iorodeo/noah_motion_system/README.txt

NOAH Motion System

Design files, software and firmware for the NOAH water tunnel motion control system.
