iorodeo/noah_motion_system/hardware/electronics/motion_controller/gerber_v0p1_r1/images/motion_controller_pcb.png

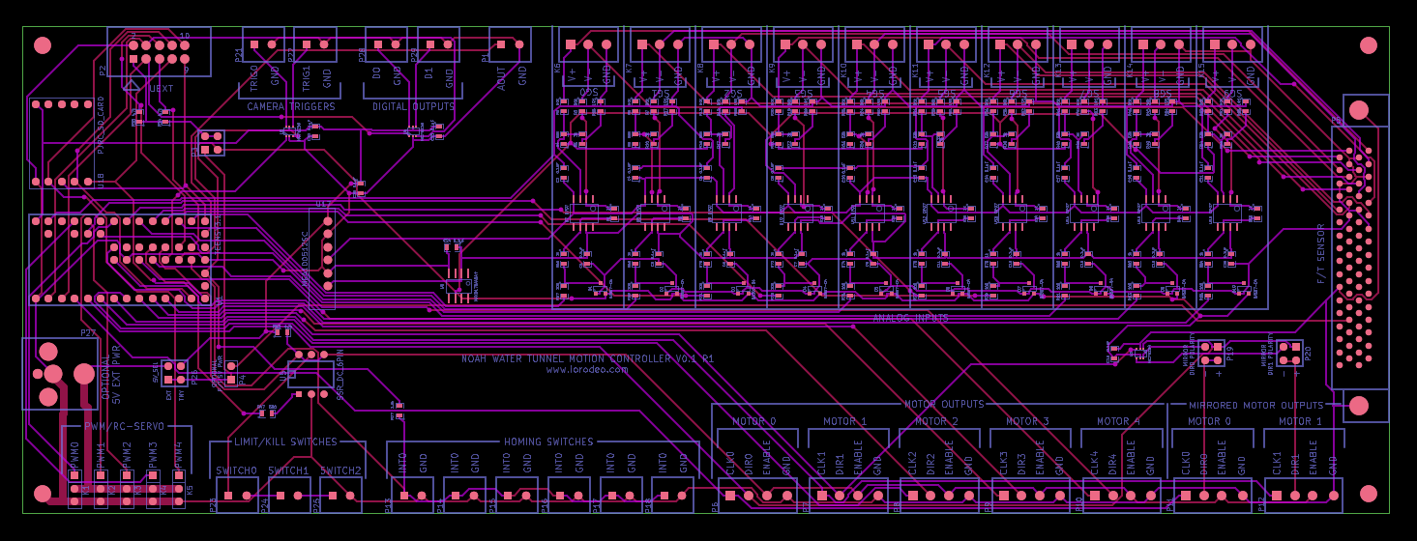
hardware/electronics/motion_controller/gerber_v0p1_r1/images/motion_controller_pcb.png
