iorodeo/noah_motion_system/hardware/mechanics/gantry_mounting_frame/mounting_frame.jpg

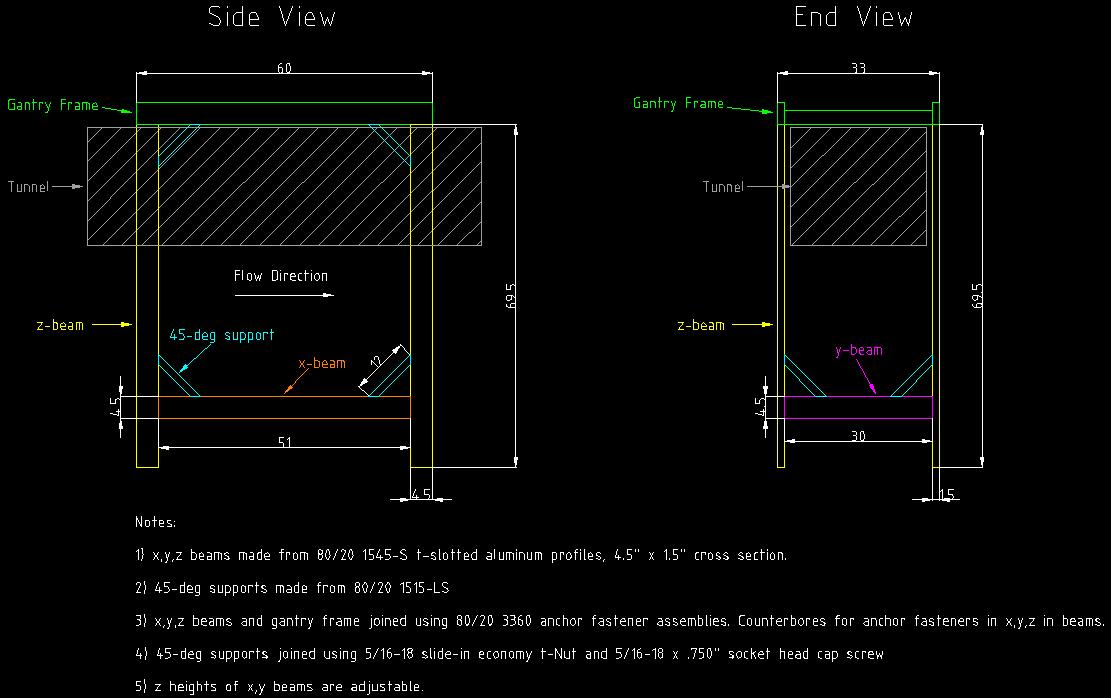
hardware/mechanics/gantry_mounting_frame/mounting_frame.jpg
