iorodeo/noah_motion_system/hardware/electronics/motion_controller/BOM.xls

 | Item # | Qty | Reference | Description | Package | PN | Vendor | Unit Cost | Cost
 | 1 | 25 | C1-C25 | 0.1 uF Ceramic Capacitor | SM0805 | 478-1395-1-ND | Digikey | 0.1 | 2.5
 | 2 | 10 | D1-D10 | Diode Array, 1-pair series conn , Schottky | SOT23 | BAS70-04-E3-08 | Digikey | 0.4 | 4
 | 3 | 15 | K1-K15 | 3-Pos. Term. Block, 3.5mm, Vert. | NA | ED2636-ND | Digikey | 0.64 | 9.6
 | 4 | 14 | P1, P13-P18, P21-P25, P28, P29 | 2-Pos. Term. Block, 3.5mm, Vert. | NA | ED2635-ND | Digikey | 0.43 | 6.02
 | 5 | 1 | P2 | 5x2 shrouded header, 0.1” | NA | S9169-ND | Digikey | 0.64 | 0.64
 | 6 | 4 | P3, P19, P20, P26 | Conn. Header 4-Pos, 2 row, 0.1” | NA | 609-3201-ND | Digkey | 0.28 | 1.12
 | 7 | 3 | P4, U1 | Conn. Header, breakaway 0.1” | NA | SAM1031-50-ND | Digikey | 3.3 | 9.9
 | 8 | 1 | P5 | 68-pin DSUB for NI cable, TE Connectivity | NA | A33476-ND | Digikey | 24.82 | 24.82
 | 9 | 7 | P6-P12 | 4-Pos. Term. Block, 3.5mm, Vert. | NA | ED2637-ND | Digikey | 0.77 | 5.39
 | 10 | 1 | P27 | 2.1mm DC Jack,high current | NA | CP-063AH-ND | Digikey | 1.78 | 1.78
 | 11 | 20 | R1, R5, R6, R10, R11, R17, R18, R22, R23, R28, R29, R33, R34, R38, R39. R43, R44, R49. R50. R55 | 3k resistor, tolerance 0.1% | SM0805 | P3.0KDACT-ND | Digikey | 0.53 | 10.6
 | 12 | 30 | R2, R3, R4, R7, R8, R9, R12, R13, R16, R19, R20, R21, R24, R25, R26, R30, R31, R32, R35, R36, R37, R40, R41, R42, R45, R46, R48, R51, R52, R54 | 50k resistor, tolerance 0.1% | SM0805 | PNM0805-50KBCT-ND | Digikey | 1.155 | 34.65
 | 13 | 3 | R14, R15, R53 | 4.7k resistor, tolerance 1% | SM0805 | 311-4.70KCRCT-ND | Digikey | 0.1 | 0.3
 | 14 | 1 | R27 | 3k resistor, tolerance 1% | SM0805 | 311-3.00KCRCT-ND | Digikey | 0.1 | 0.1
 | 15 | 10 | R56-R65 | 191 Ohm resistor, tolerance 0.1% | SM0805 | P191DACT-ND | Digikey | 0.63 | 6.3
 | 16 | 10 | R66, R68, R70, R72, R74, R76, R78, R80, R82, R84 | 1k resistor, tolerance 1% | SM0805 | 311-1.00KCRCT-ND | Digikey | 0.1 | 1
 | 17 | 10 | R67, R69, R71, R73, R75, R77, R79, R81, R83, R85 | 100 Ohm resistor, tolerance 1% | SM0805 | 311-100CRCT-ND | Digikey | 0.1 | 1
 | 18 | 1 | R47 | 499 Ohm resistor, tolerance 1% | SM0805 | 311-499CRCT-ND | Digikey | 0.1 | 0.1
 | 19 | 1 | U2 | NC7WZ04 Tiny logic Dual Inverter | SC-70-6 | NC7WZ04P6XCT-ND | Digikey | 0.41 | 0.41
 | 20 | 2 | U3, U4 | NC7WZ16 Tiny Logic Dual Buffer | SC-70-6 | NC7WZ16P6XCT-ND | Digikey | 0.39 | 0.78
 | 21 | 1 | U5 | LCA710 Solid State Relay | 6-DIP (0.3") | CLA181-ND | Digikey | 4.76 | 4.76
 | 22 | 1 | U5 | DIP Socket 6-Pos (3x2) | 6-DIP (0.3”) | AE1485-ND | Digikey | 0.24 | 0.24
 | 23 | 1 | U6 | Precision Voltage Reference (10V) | 8-SOIC | MAX6176AASA+-ND | Digikey | 4.57 | 4.57
 | 24 | 10 | U7-U16 | OP07x Precision Operational Amplifiers | 8-SOIC | 296-14626-1-ND | Digikey | 1.12 | 11.2
 | 25 | 1 | U17 | DC/DC converter +/-12V | 6-SIP Module (5 Leads) | 811-2678-5-ND | Digikey | 5.45 | 5.45
 | 26 | 1 | U18 | Micro SD Card Adaptor | NA | SD_ADAPTOR | PJRC | 8 | 8
 | 27 | 1 | U1 | Teensy 3.2 | NA | DEV-13736 | Sparkfun | 19.95 | 19.95
 | 28 | 1 | U1 | Surface mount header for Teensy 3.2 | NA | WM17453-ND | Digikey | 1.04 | 1.04
 | 29 | 2 | U1 | Female header for Teensy socket | NA | 929974E-01-36-ND | Digikey | 2.74 | 5.48
Totals | 29 | 188 |  |  |  |  |  |  | 181.7
 | Notes:
 | * P30-P33 are mounting holes – there is no component for these items.
 | * Alternate choice for item #12, 49.9k resistor, P49.9KDACT-ND, cost 0.63
