iorodeo/noah_motion_system/hardware/mechanics/gantry_mounting_frame/BOM.xlsx

Mounting Frame
Description | Quantity | Vendor | PN | price | subtotal
T-Slotted Aluminum Profile 1545-S, 69.5in Length, anchor counterbore E, H left end (see note1) | 4 | 80/20 | 1545-S | 105.5 | 422
T-Slotted Aluminum Profile 1545-S, 51.0in Length, anchor counterbore E, H left end right (see note1) | 2 | 80/20 | 1545-S | 84.35 | 168.7
T-Slotted Aluminum Profile 1545-S, 30.0in Length, anchor counterbore E, H left and right (see note1) | 2 | 80/20 | 1535-S | 62.75 | 125.5
15 Series 4.5" Economy Floor Mount Base Plate | 8 | 80/20 | 2405 | 15 | 120
15 Series 5/16-18 Standard Anchor Fastener Assembly | 30 | 80/20 | 3360 | 3.15 | 94.5
1515-LS 45 Degree Support, 12" Long | 12 | 80/20 | 2542 | 16.15 | 193.8
Bolt Assembly: 5/16-18 x .687" Black FBHSCS with Slide-In Economy T-Nut - Offset Thread - Black Zinc | 72 | 80/20 | 3320 | 0.6 | 43.2
 |  |  |  | Total | 1167.7
Note 1: See page 567 of 80/20 catalog for anchor fastener designations.
