iorodeo/noah_motion_system/hardware/mechanics/gantry_parts/BOM.xlsx

Motion Control Mechanics & Drive Electronics
Description | Quantity | Vendor | PN | price | subtotal
CRP2448 xyz CNC gantry kit w/ 3060 gantry extrusion, Nema 34 compatible | 1 | CNC router parts | CRP2448 | 2320 | 2320
4-axis Nema 34 Electronics kit, 2x12' & 2x20' cable, drive type G203V | 1 | CNC router parts | NA | 1549 | 1549
PMDX-133 3-axis daisey chainable mother board | 2 | CNC router parts | NA | 49 | 98
26-pin female-to-female ribbon cable 18" | 4 | PMDX | PMDX-HDR26Ribbon-18 | 8 | 32
7A Bulkhead Enclosure Connector | 3 | CNC router parts | NA | 11.95 | 35.85
High current CNC motor cable | 2 | CNC router parts | NA | 27.95 | 55.9
CRP2448 cable track kit | 1 | CNC router parts | NA | 199 | 199
48V 21A Power Supply | 1 | CNC router parts | NA | 239 | 239
3700 CNC rotary axis w/ motor mount | 1 | Sherline Direct | 3700-CNC | 336 | 336
3701 rotary axis right angle attachment plate | 1 | Sherline Direct | 3701-RIGHTANGLE | 78.75 | 78.75
Rotary axis tooling plate | 1 | Sherline | 3725 | 47.25 | 47.25
Nema 23 240 oz-in bipolar stepper | 2 | Stepperonline | 274 | 24.43 | 48.86
Gecko G213V digital step drive | 2 | Gecko Drive | G213V | 166 | 332
Finned heat sink for 3 Gecko drives | 2 | Gecko Drive | NA | 74 | 148
Rectangular Normally-Open NPN-style Proximity Sensor | 5 | PMDX | PMDX-PROX-01 | 21 | 105
Omron lever SPDT limit switch | 10 | Digikey | SW703-ND | 2.67 | 26.7
3-wire limit switch cable (per ft) | 100 | Light Object | LSR-SNRCBL3 | 0.25 | 25
2-wire limit switch cable (per ft) | 200 | Light Object | LSR-SNRCBL2 | 0.25 | 50
MK20DX256VLH7 Cortex-M4 via Teensy 3.2 development board | 2 | Sparkfun | DEV-13736 | 19.95 | 39.9
(Optional) 3/4" Stainless Steel Two Bolt Flange Bearing SSUCFL204-12 | 1 | Big Bearing Store | SSUCFL204-12 | 38.98 | 38.98
(Optional) Aluminum Helical Flexible Shaft Coupling, 3/4" x 3/4" Diameter Shaft, 2-3/4" Long | 1 | McMaster Carr | 6208K699 | 89.81 | 89.81
 |  |  |  | Total | 5895
