iorodeo/noah_motion_system/hardware/mechanics/electronics_mount/main_plate/cnc/#main_plate.dxf

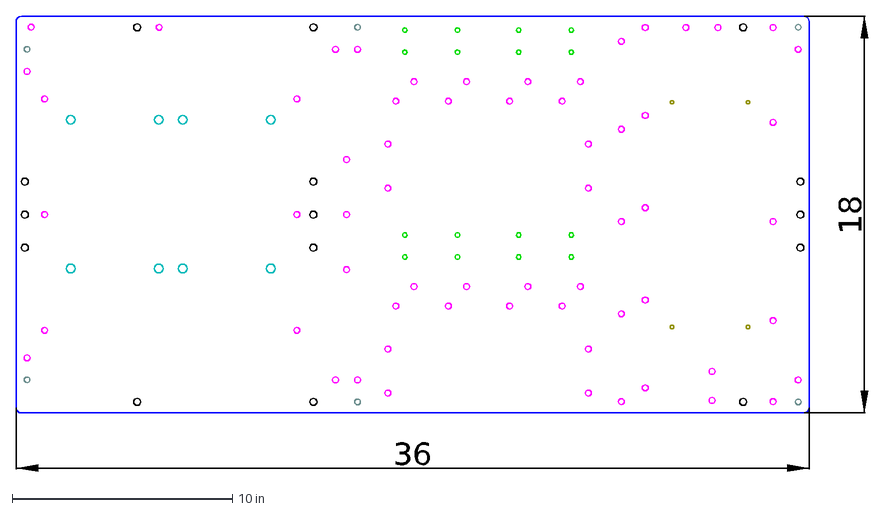
[picture p4: CAD file, 2016-08-04]
hardware/mechanics/electronics_mount/main_plate/cnc/#main_plate.dxf
18
36
