iorodeo/noah_motion_system/hardware/mechanics/electronics_mount/mdf_main_plate_backing/cnc/mdf_main_plate_backing.dxf

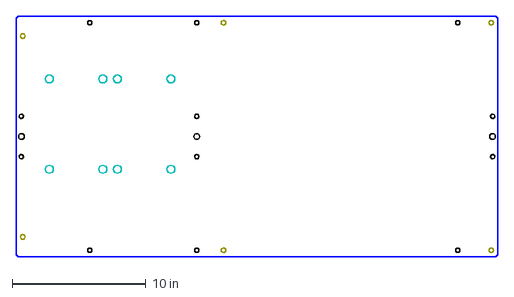
[picture p5: CAD file, 2016-08-01]
hardware/mechanics/electronics_mount/mdf_main_plate_backing/cnc/mdf_main_plate_backing.dxf
36.0 x 18.0 in
