iorodeo/noah_motion_system/hardware/mechanics/gantry_parts/carriage_mods/design_v2/assembly.dxf

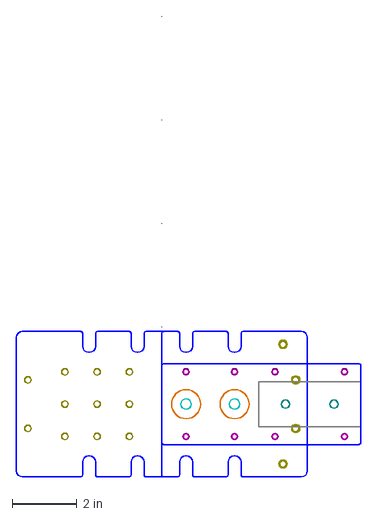
[picture p6: CAD file, 2016-06-24]
hardware/mechanics/gantry_parts/carriage_mods/design_v2/assembly.dxf
10.7 x 14.2 in
