iorodeo/noah_motion_system/hardware/mechanics/electronics_mount/acrylic_cover_plates/cnc/lasercutting/upper_cover_plate.dxf

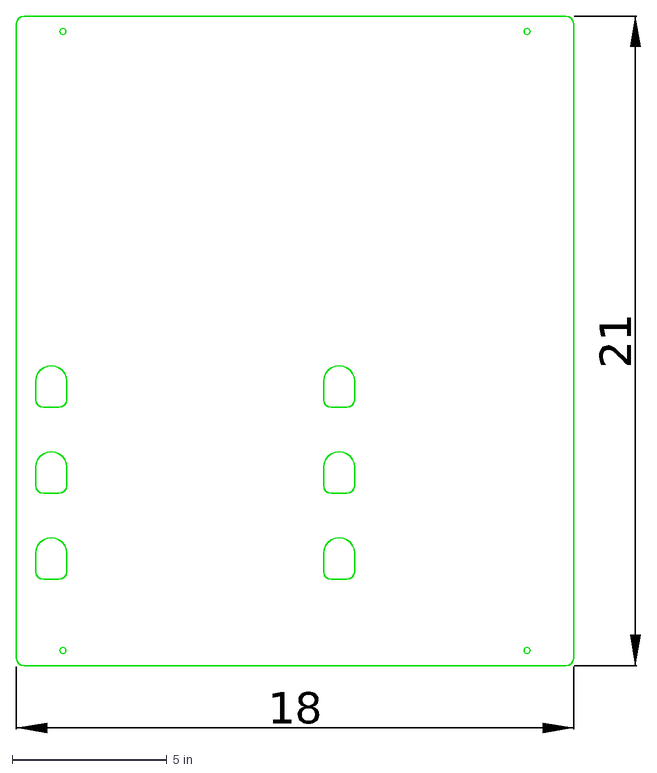
[picture p7: CAD file, 2016-10-04]
hardware/mechanics/electronics_mount/acrylic_cover_plates/cnc/lasercutting/upper_cover_plate.dxf
21
18
