iorodeo/noah_motion_system/hardware/mechanics/electronics_mount/bulkhead_connector_plate/bulkhead_connector_plate.dxf

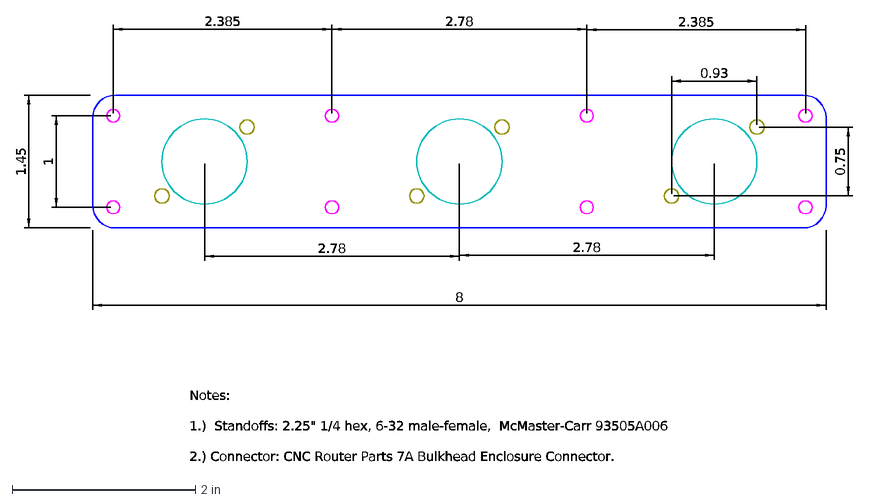
[picture p8: CAD file, 2016-07-22]
hardware/mechanics/electronics_mount/bulkhead_connector_plate/bulkhead_connector_plate.dxf
2.78
8
1.45
1
0.93
0.75
2.385
Notes: 1.) Standoffs: 2.25" 1/4 hex, 6-32 male-female, McMaster-Carr 93505A006 2.) Connector: CNC Router Parts 7A Bulkhead Enclosure Connector.
