iorodeo/noah_motion_system/hardware/mechanics/electronics_mount/bulkhead_connector_plate/cnc/layout.dxf

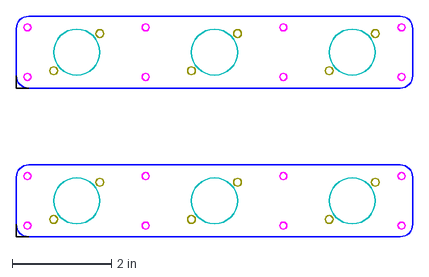
[picture p9: CAD file, 2016-07-28]
hardware/mechanics/electronics_mount/bulkhead_connector_plate/cnc/layout.dxf
8.00 x 4.45 in
