iorodeo/noah_motion_system/hardware/mechanics/electronics_mount/mdf_switch_plate_backing/cnc/mdf_switch_plate_backing.dxf

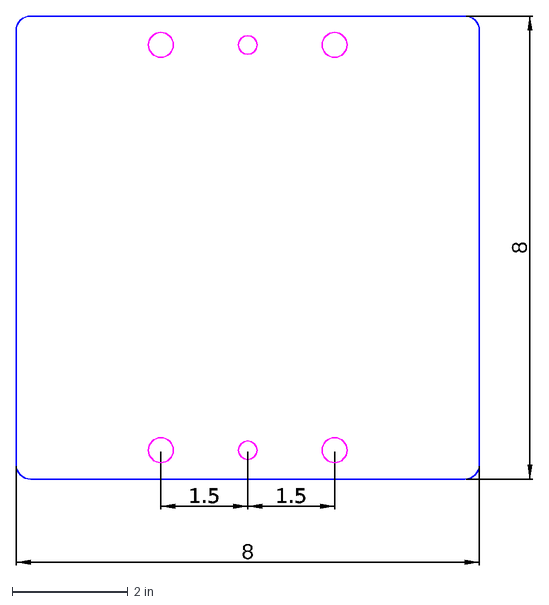
[picture p10: CAD file, 2016-07-31]
hardware/mechanics/electronics_mount/mdf_switch_plate_backing/cnc/mdf_switch_plate_backing.dxf
8
1.5
