iorodeo/noah_motion_system/hardware/mechanics/electronics_mount/mdf_switch_plate_backing/mdf_switch_plate_backing.dxf

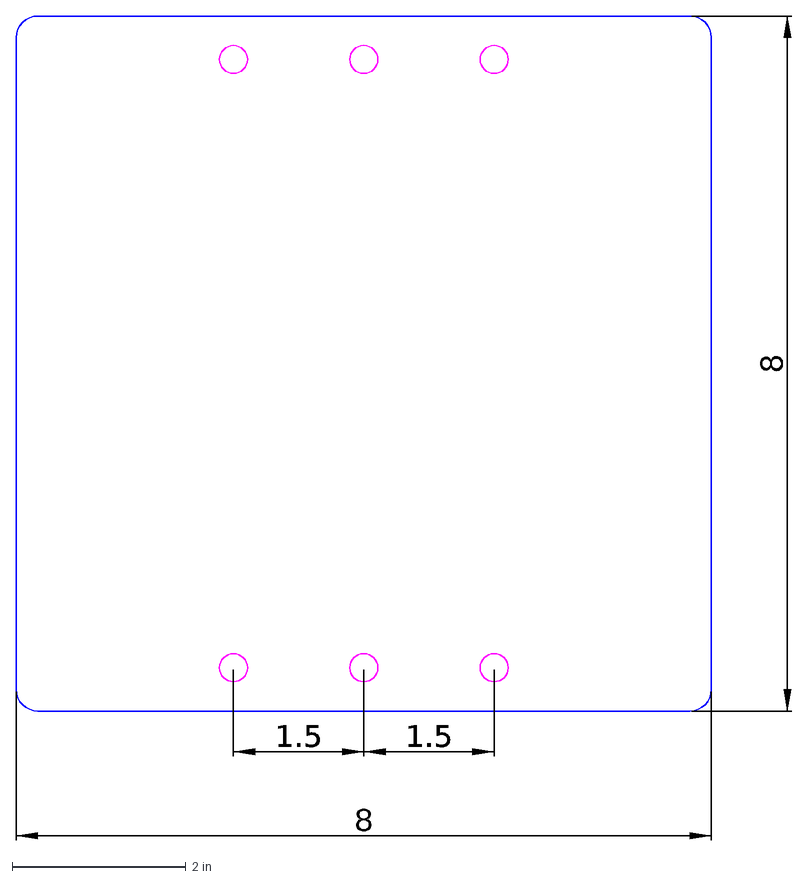
[picture p11: CAD file, 2016-07-30]
hardware/mechanics/electronics_mount/mdf_switch_plate_backing/mdf_switch_plate_backing.dxf
8
1.5
