iorodeo/noah_motion_system/hardware/mechanics/electronics_mount/power_supply_plate/cnc/power_supply_plate.dxf

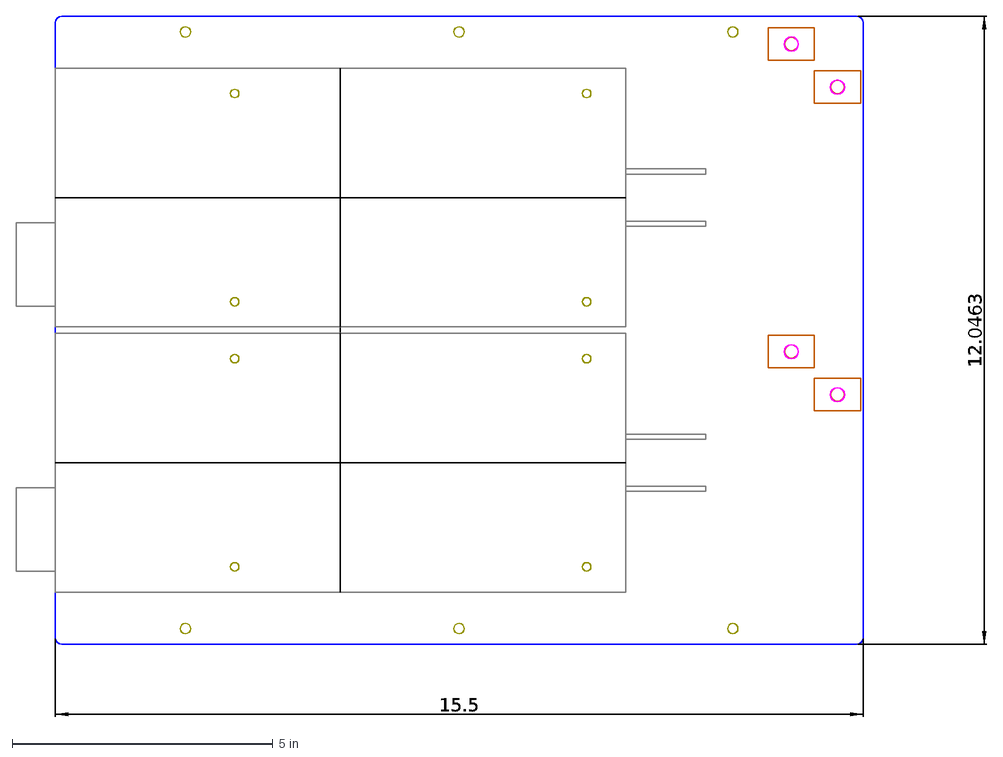
[picture p12: CAD file, 2016-07-30]
hardware/mechanics/electronics_mount/power_supply_plate/cnc/power_supply_plate.dxf
12.0463
15.5
