iorodeo/noah_motion_system/hardware/mechanics/electronics_mount/power_supply_plate/power_supply_plate.dxf

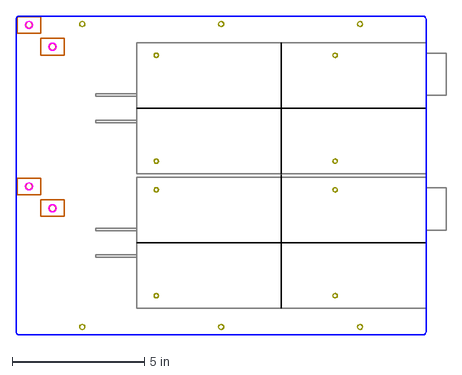
[picture p13: CAD file, 2016-07-27]
hardware/mechanics/electronics_mount/power_supply_plate/power_supply_plate.dxf
16.2 x 12.0 in
