iorodeo/noah_motion_system/hardware/mechanics/electronics_mount/power_switch_plate/cnc/power_switch_plate.dxf

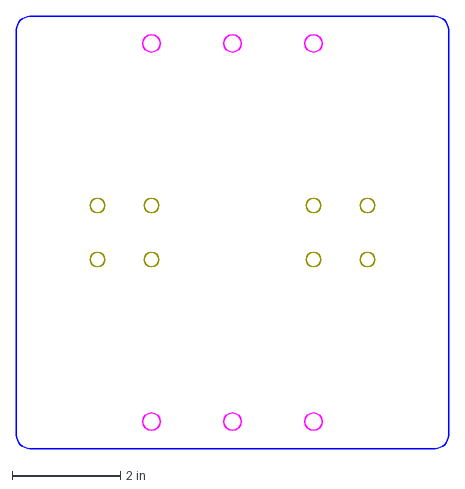
[picture p14: CAD file, 2016-07-22]
hardware/mechanics/electronics_mount/power_switch_plate/cnc/power_switch_plate.dxf
8.00 x 8.00 in
