iorodeo/noah_motion_system/hardware/mechanics/electronics_mount/power_switch_plate/power_switch_plate.dxf

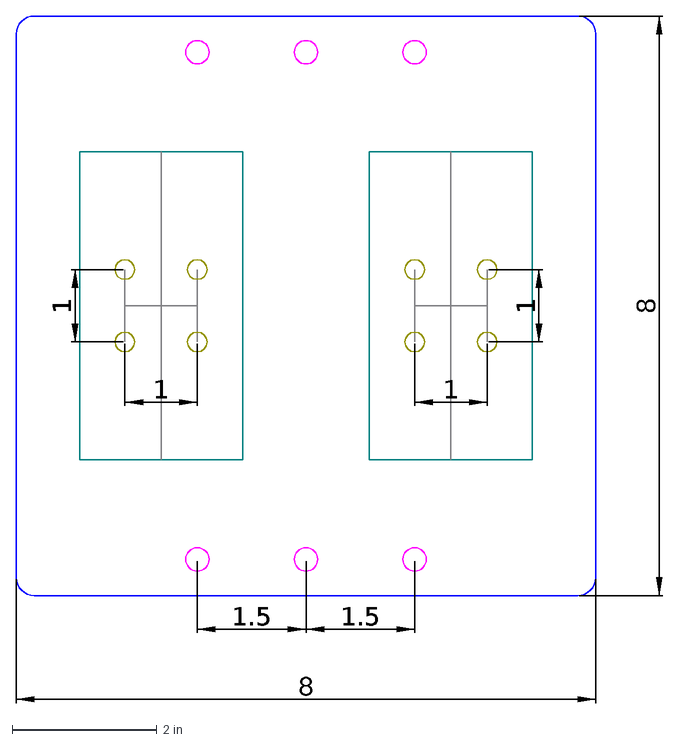
[picture p15: CAD file, 2016-07-22]
hardware/mechanics/electronics_mount/power_switch_plate/power_switch_plate.dxf
8
1.5
1
