iorodeo/noah_motion_system/hardware/mechanics/gantry/force_sensor_mount/force_sensor_to_model_2.dxf

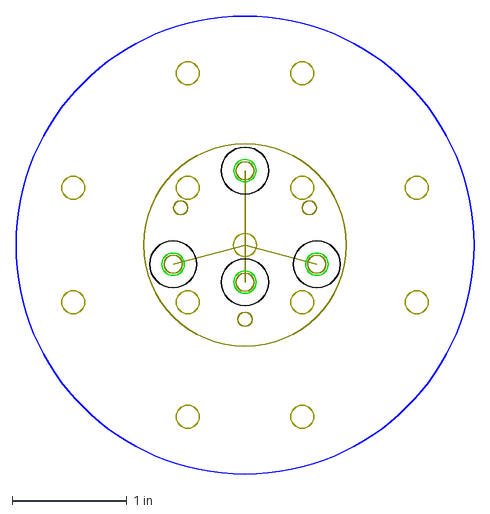
[picture p16: CAD file, 2016-07-18]
hardware/mechanics/gantry/force_sensor_mount/force_sensor_to_model_2.dxf
4.00 x 4.00 in
