iorodeo/noah_motion_system/hardware/mechanics/gantry_mounting_frame/foot_blocks/lower_block.dxf

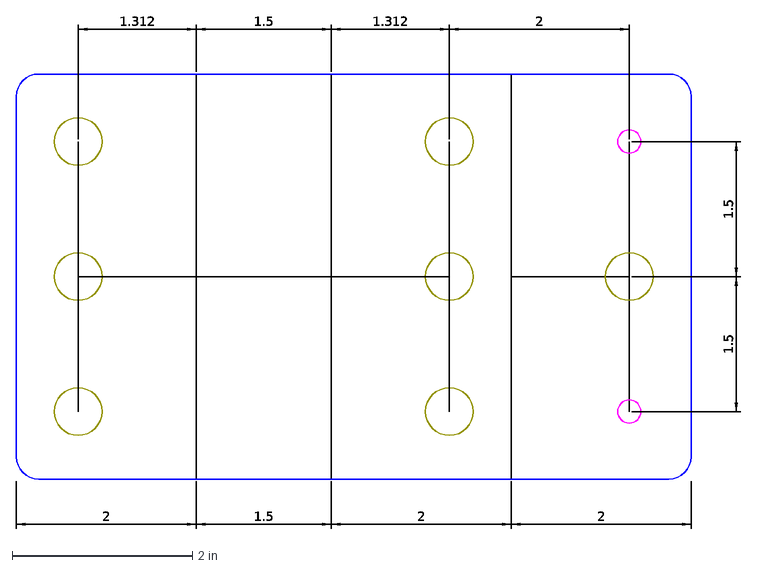
[picture p17: CAD file, 2016-08-03]
hardware/mechanics/gantry_mounting_frame/foot_blocks/lower_block.dxf
2
1.5
1.312
