iorodeo/noah_motion_system/hardware/mechanics/gantry_mounting_frame/mdf_riser_blocks/cnc/0p25in/layout.dxf

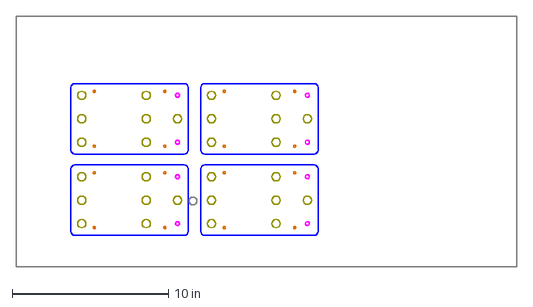
[picture p18: CAD file, 2016-08-04]
hardware/mechanics/gantry_mounting_frame/mdf_riser_blocks/cnc/0p25in/layout.dxf
32.0 x 16.0 in
