iorodeo/noah_motion_system/hardware/mechanics/gantry_mounting_frame/mdf_riser_blocks/cnc/0p75in/layout.dxf

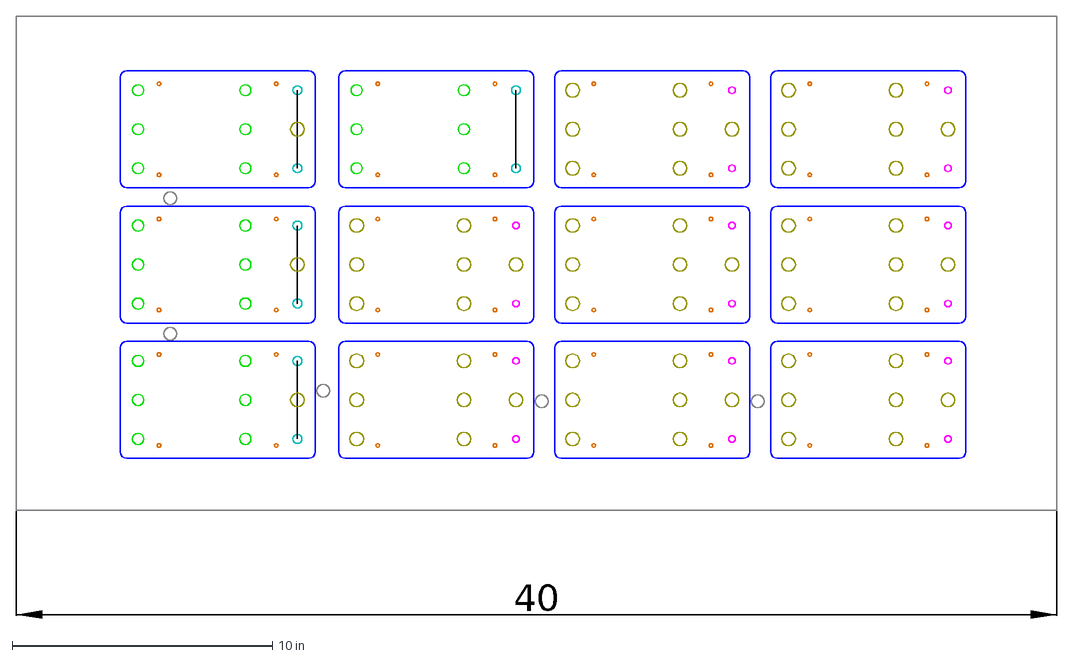
[picture p19: CAD file, 2016-08-04]
hardware/mechanics/gantry_mounting_frame/mdf_riser_blocks/cnc/0p75in/layout.dxf
40
