iorodeo/noah_motion_system/hardware/mechanics/gantry_mounting_frame/mdf_riser_blocks/lower_block.dxf

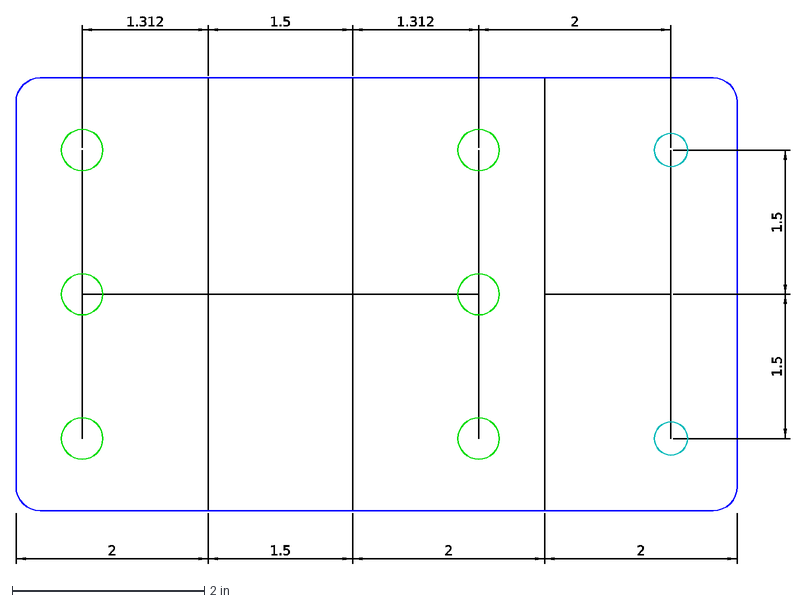
[picture p20: CAD file, 2016-08-03]
hardware/mechanics/gantry_mounting_frame/mdf_riser_blocks/lower_block.dxf
2
1.5
1.312
