iorodeo/noah_motion_system/hardware/mechanics/gantry_mounting_frame/mounting_frame.dxf

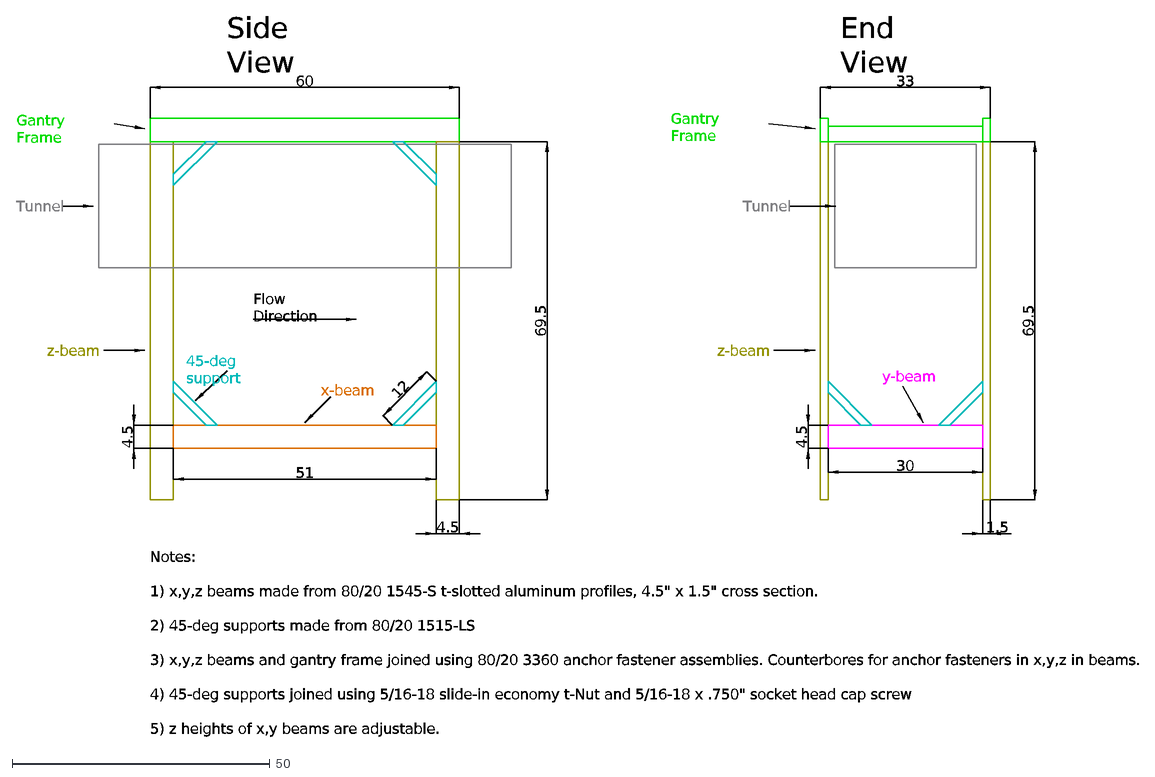
[picture p21: CAD file, 2015-11-16]
hardware/mechanics/gantry_mounting_frame/mounting_frame.dxf
69.5
60
51
30
33
Flow Direction
Gantry Frame
Tunnel
z-beam
y-beam
4.5
1.5
x-beam
12
Side View
End View
45-deg support
Notes: 1) x,y,z beams made from 80/20 1545-S t-slotted aluminum profiles, 4.5" x 1.5" cross section. 2) 45-deg supports made from 80/20 1515-LS 3) x,y,z beams a
