iorodeo/noah_motion_system/hardware/mechanics/gantry_parts/carriage_mods/design_v2/lower_gantry_plate.dxf

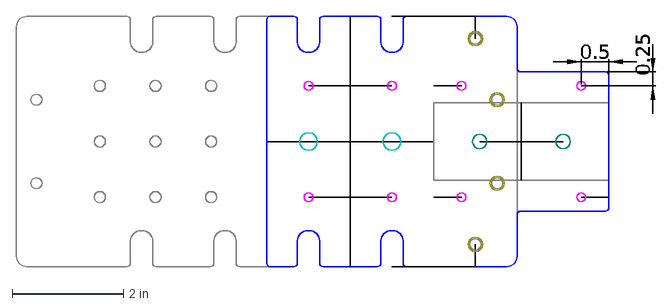
[picture p22: CAD file, 2016-06-24]
hardware/mechanics/gantry_parts/carriage_mods/design_v2/lower_gantry_plate.dxf
0.25
0.5
