iorodeo/noah_motion_system/hardware/mechanics/gantry_parts/cnc/lasercutting_layouts/0p25in_acrylic/type5/bottom_plate.dxf

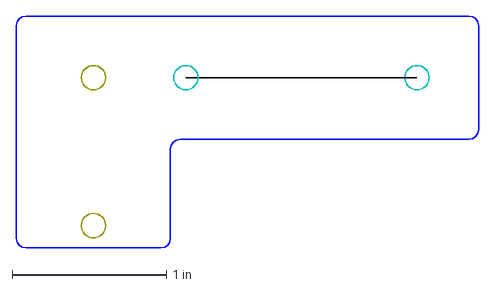
[picture p23: CAD file, 2017-03-04]
hardware/mechanics/gantry_parts/cnc/lasercutting_layouts/0p25in_acrylic/type5/bottom_plate.dxf
3.00 x 1.50 in
