iorodeo/noah_motion_system/hardware/mechanics/gantry_parts/cnc/lasercutting_layouts/0p25in_acrylic/type_1_and_2/limit_switch_mounts_layout3.dxf

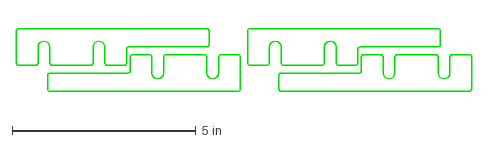
[picture p24: CAD file, 2016-10-04]
hardware/mechanics/gantry_parts/cnc/lasercutting_layouts/0p25in_acrylic/type_1_and_2/limit_switch_mounts_layout3.dxf
12.4 x 1.71 in
