iorodeo/noah_motion_system/hardware/mechanics/gantry_parts/cnc/lasercutting_layouts/0p25in_acrylic/type_3_and_4/type_3_and_4_layout_1.dxf

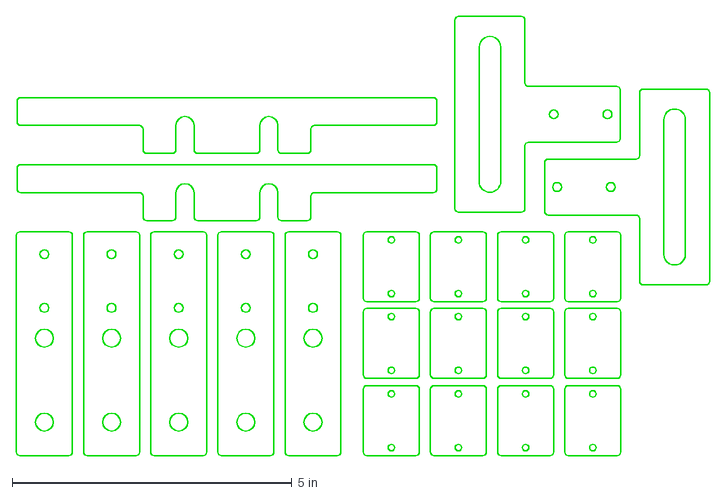
[picture p25: CAD file, 2016-12-08]
hardware/mechanics/gantry_parts/cnc/lasercutting_layouts/0p25in_acrylic/type_3_and_4/type_3_and_4_layout_1.dxf
12.4 x 7.85 in
