iorodeo/noah_motion_system/hardware/mechanics/gantry_parts/cnc/waterjet_layouts/0p25in_aluminum/force_sensor_plus_rotary_mount.dxf

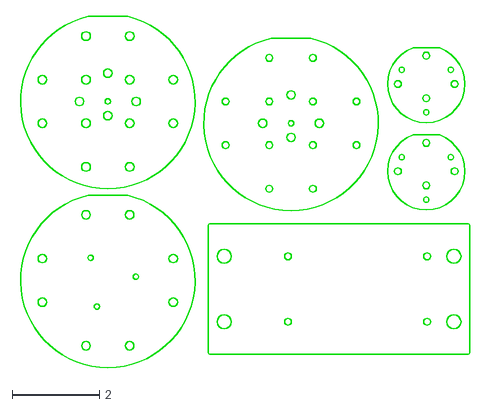
[picture p26: CAD file, 2016-07-18]
hardware/mechanics/gantry_parts/cnc/waterjet_layouts/0p25in_aluminum/force_sensor_plus_rotary_mount.dxf
10.4 x 8.05
