iorodeo/noah_motion_system/hardware/mechanics/gantry_parts/force_sensor_mount/force_sensor_to_model_1.dxf

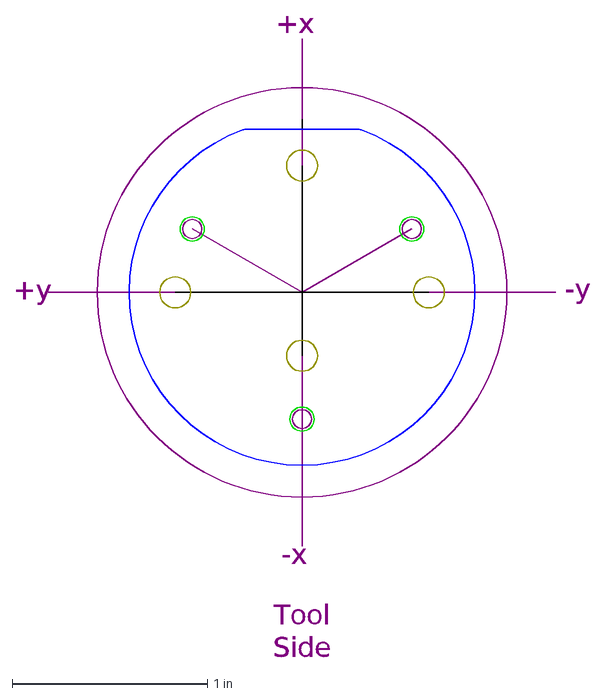
[picture p27: CAD file, 2016-07-22]
hardware/mechanics/gantry_parts/force_sensor_mount/force_sensor_to_model_1.dxf
-x
+x
Tool Side
+y
-y
