iorodeo/noah_motion_system/hardware/mechanics/gantry_parts/limit_switch_mount/type1/bottom_plate.dxf

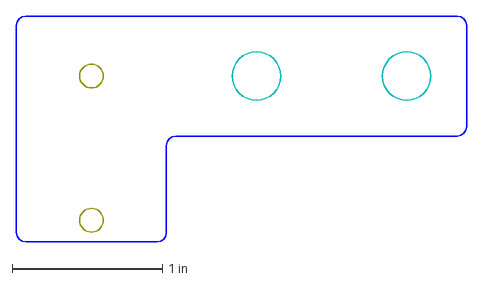
[picture p28: CAD file, 2016-07-02]
hardware/mechanics/gantry_parts/limit_switch_mount/type1/bottom_plate.dxf
3.00 x 1.50 in
