iorodeo/noah_motion_system/hardware/mechanics/gantry_parts/limit_switch_mount/type3/bottom_plate.dxf

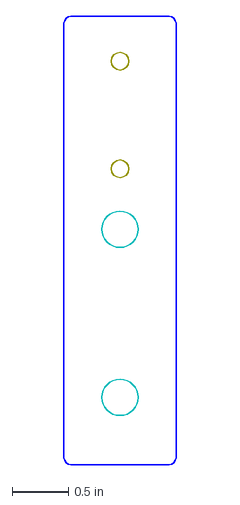
[picture p29: CAD file, 2016-12-08]
hardware/mechanics/gantry_parts/limit_switch_mount/type3/bottom_plate.dxf
1.00 x 4.00 in
