iorodeo/noah_motion_system/hardware/mechanics/gantry_parts/limit_switch_mount/type4/carriage_switch_mount.dxf

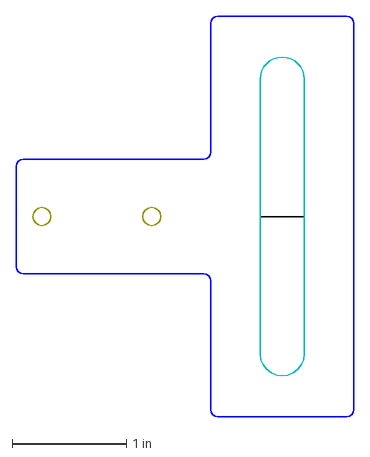
[picture p30: CAD file, 2016-12-08]
hardware/mechanics/gantry_parts/limit_switch_mount/type4/carriage_switch_mount.dxf
2.95 x 3.50 in
