iorodeo/noah_motion_system/hardware/mechanics/gantry_parts/rotary_axis_mount/rotary_axis_mount_plate.dxf

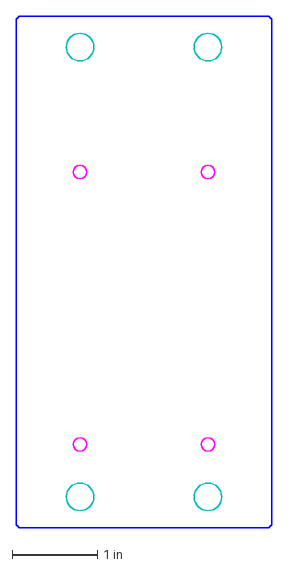
[picture p31: CAD file, 2016-07-18]
hardware/mechanics/gantry_parts/rotary_axis_mount/rotary_axis_mount_plate.dxf
3.00 x 6.00 in
