iorodeo/noah_motion_system/mechanics/gantry_and_drive_electronics/gantry_carriage_plate/gantry_carriage_plate.dxf

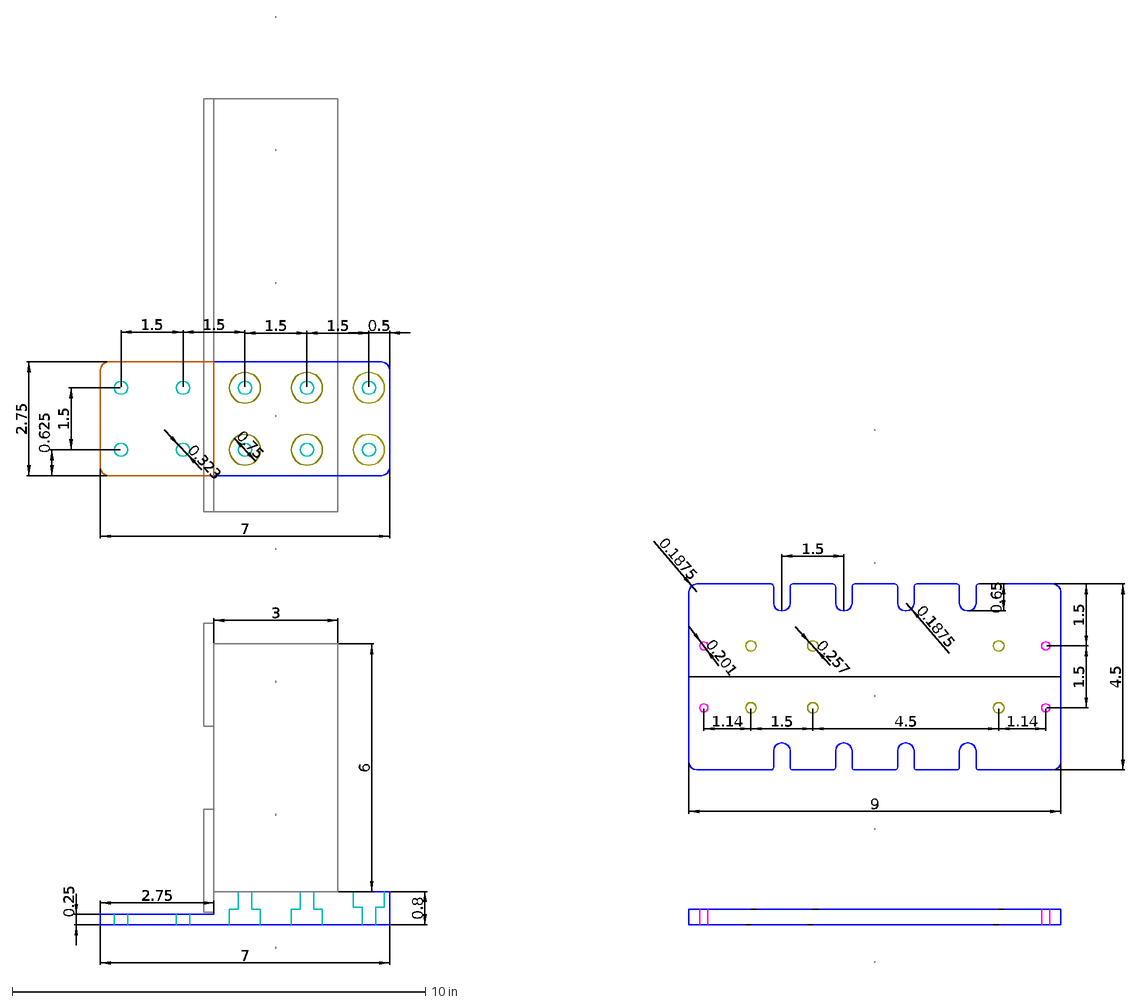
[picture p32: CAD file, 2015-11-30]
mechanics/gantry_and_drive_electronics/gantry_carriage_plate/gantry_carriage_plate.dxf
2.75
1.5
7
0.8
0.25
0.5
0.625
6
3
9
0.65
0.1875
4.5
1.14
0.201
0.257
0.323
0.75
