iorodeo/noah_motion_system/hardware/mechanics/electronics_mount/acrylic_cover_plates/cnc/lasercutting/lower_cover_plate.dxf

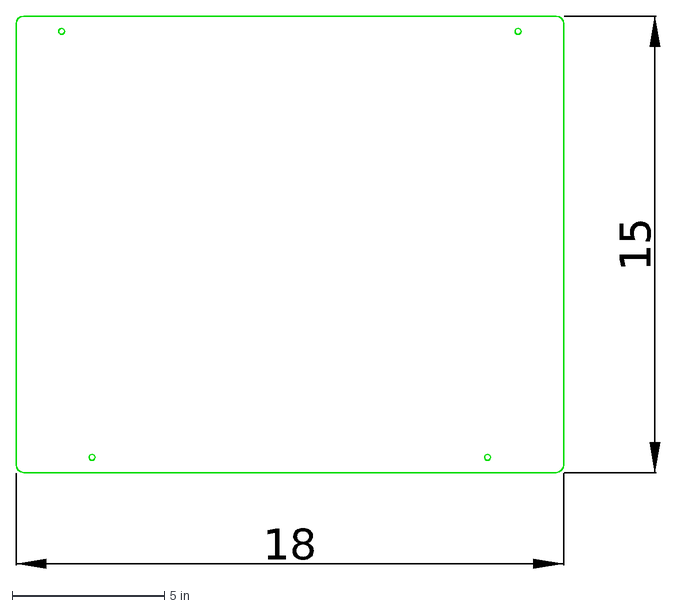
[picture p33: CAD file, 2016-10-04]
hardware/mechanics/electronics_mount/acrylic_cover_plates/cnc/lasercutting/lower_cover_plate.dxf
15
18
