iorodeo/noah_motion_system/hardware/mechanics/electronics_mount/main_plate/motion_controller_pcb.dxf

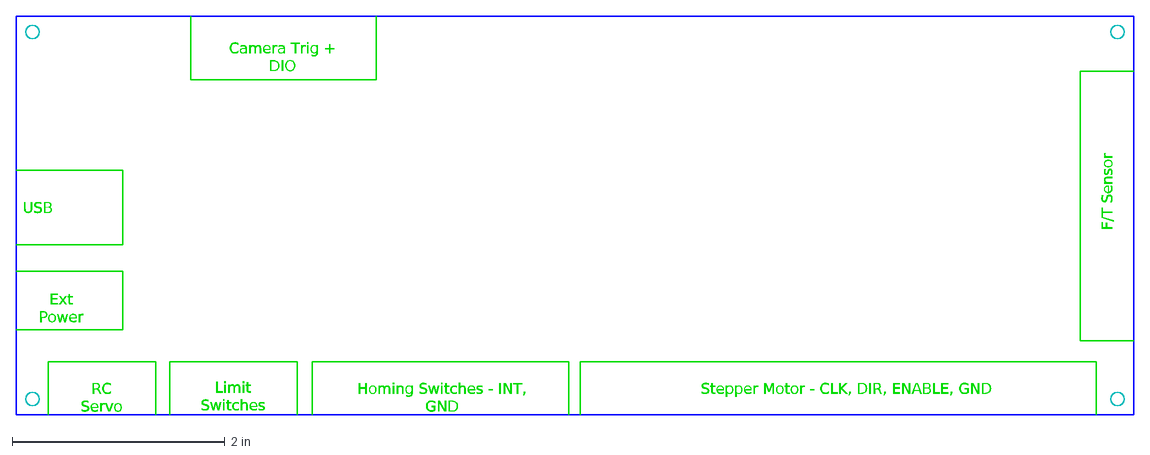
[picture p34: CAD file, 2016-07-25]
hardware/mechanics/electronics_mount/main_plate/motion_controller_pcb.dxf
Homing Switches - INT, GND
Stepper Motor - CLK, DIR, ENABLE, GND
Limit Switches
RC Servo
Ext Power
USB
F/T Sensor
Camera Trig + DIO
