iorodeo/noah_motion_system/hardware/mechanics/gantry_parts/carriage_mods/design_v2/carriage_plate.dxf

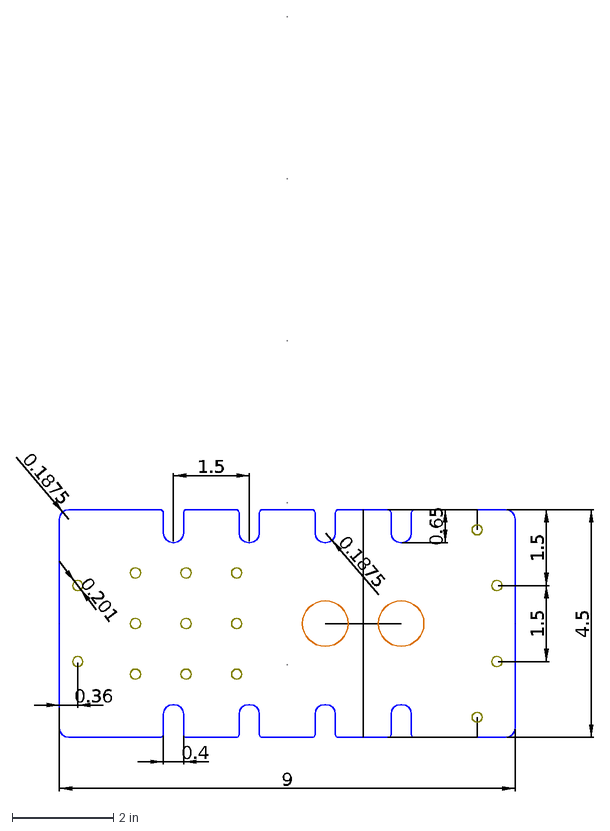
[picture p35: CAD file, 2016-06-24]
hardware/mechanics/gantry_parts/carriage_mods/design_v2/carriage_plate.dxf
9
1.5
0.65
0.1875
4.5
0.201
0.4
0.36
