iorodeo/noah_motion_system/hardware/mechanics/gantry_parts/cnc/lasercutting_layouts/0p25in_acrylic/type5/layout.dxf

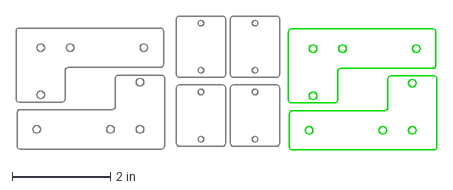
[picture p36: CAD file, 2017-03-04]
hardware/mechanics/gantry_parts/cnc/lasercutting_layouts/0p25in_acrylic/type5/layout.dxf
8.56 x 2.73 in
