iorodeo/noah_motion_system/hardware/mechanics/gantry_parts/cnc/lasercutting_layouts/0p25in_acrylic/type_1_and_2/limit_switch_mounts_layout2.dxf

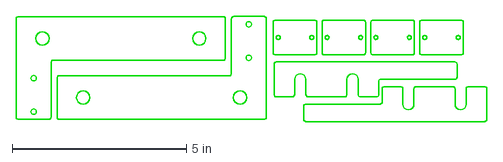
[picture p37: CAD file, 2016-07-16]
hardware/mechanics/gantry_parts/cnc/lasercutting_layouts/0p25in_acrylic/type_1_and_2/limit_switch_mounts_layout2.dxf
13.5 x 3.01 in
