iorodeo/noah_motion_system/hardware/mechanics/gantry_parts/cnc/waterjet_layouts/0p25in_aluminum/carriage_mods_plus_rotary_mount.dxf

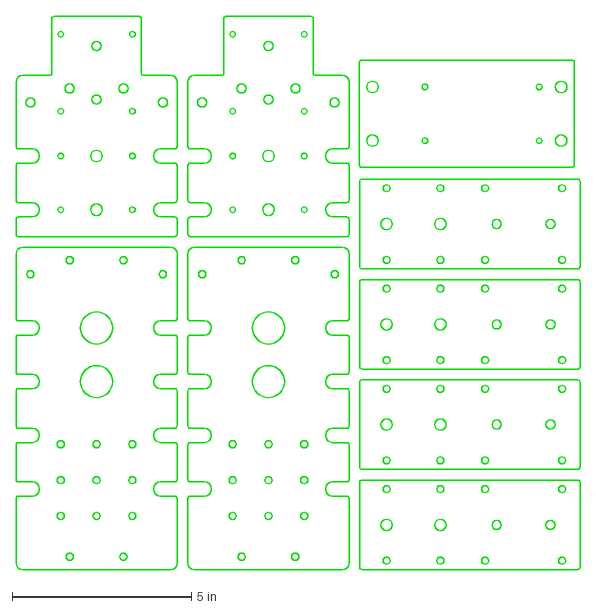
[picture p38: CAD file, 2016-07-18]
hardware/mechanics/gantry_parts/cnc/waterjet_layouts/0p25in_aluminum/carriage_mods_plus_rotary_mount.dxf
15.8 x 15.4 in
