iorodeo/noah_motion_system/hardware/mechanics/gantry_parts/force_sensor_mount/force_sensor_to_model_2_10-32.dxf

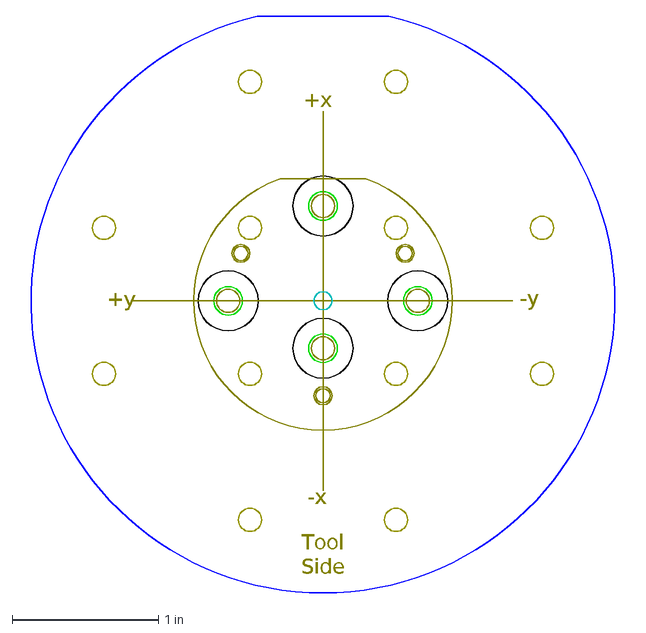
[picture p39: CAD file, 2016-07-18]
hardware/mechanics/gantry_parts/force_sensor_mount/force_sensor_to_model_2_10-32.dxf
-x
+x
Tool Side
+y
-y
