iorodeo/noah_motion_system/hardware/mechanics/gantry_parts/limit_switch_mount/type4/vertical_axis_mount.dxf

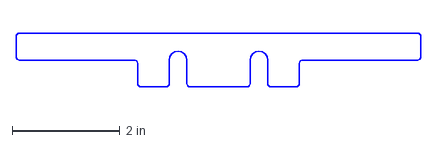
[picture p40: CAD file, 2016-12-08]
hardware/mechanics/gantry_parts/limit_switch_mount/type4/vertical_axis_mount.dxf
7.50 x 1.00 in
