iorodeo/noah_motion_system/hardware/mechanics/gantry_parts/limit_switch_mount/type5/top_plate.dxf

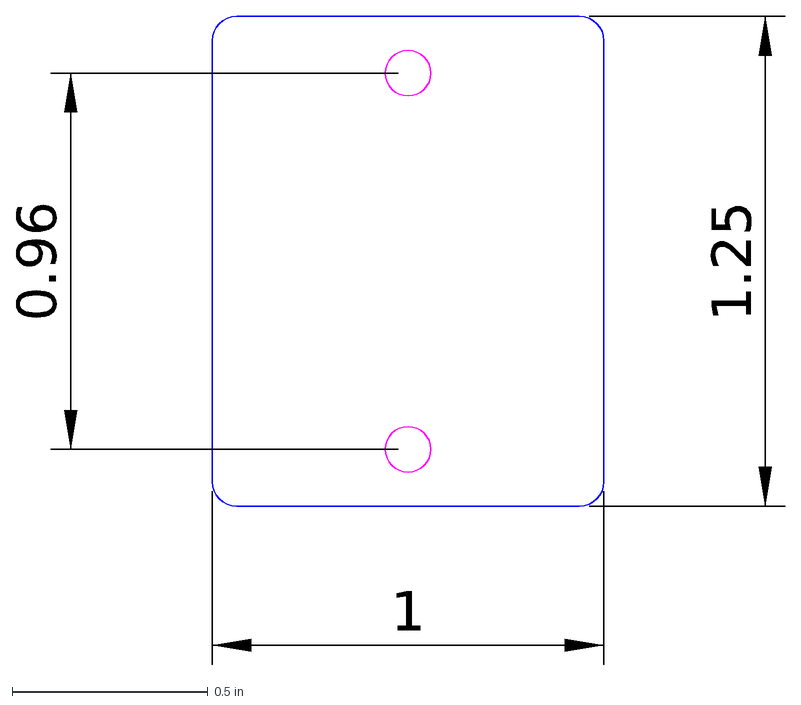
[picture p41: CAD file, 2016-07-02]
hardware/mechanics/gantry_parts/limit_switch_mount/type5/top_plate.dxf
1.25
1
0.96
