iorodeo/noah_motion_system/hardware/mechanics/electronics_mount/main_plate/finned_heat_sink.dxf

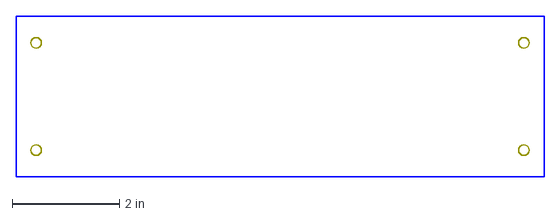
[picture p42: CAD file, 2016-07-25]
hardware/mechanics/electronics_mount/main_plate/finned_heat_sink.dxf
9.85 x 3.00 in
