iorodeo/noah_motion_system/hardware/mechanics/gantry_parts/cnc/lasercutting_layouts/0p25in_acrylic/type_1_and_2/limit_switch_mounts_layout1.dxf

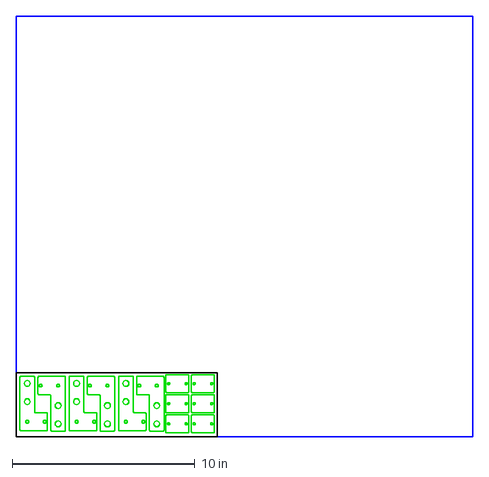
[picture p43: CAD file, 2016-07-02]
hardware/mechanics/gantry_parts/cnc/lasercutting_layouts/0p25in_acrylic/type_1_and_2/limit_switch_mounts_layout1.dxf
25.0 x 23.0 in
