iorodeo/noah_motion_system/hardware/mechanics/gantry_parts/force_sensor_mount/force_sensor_to_tooling_plate.dxf

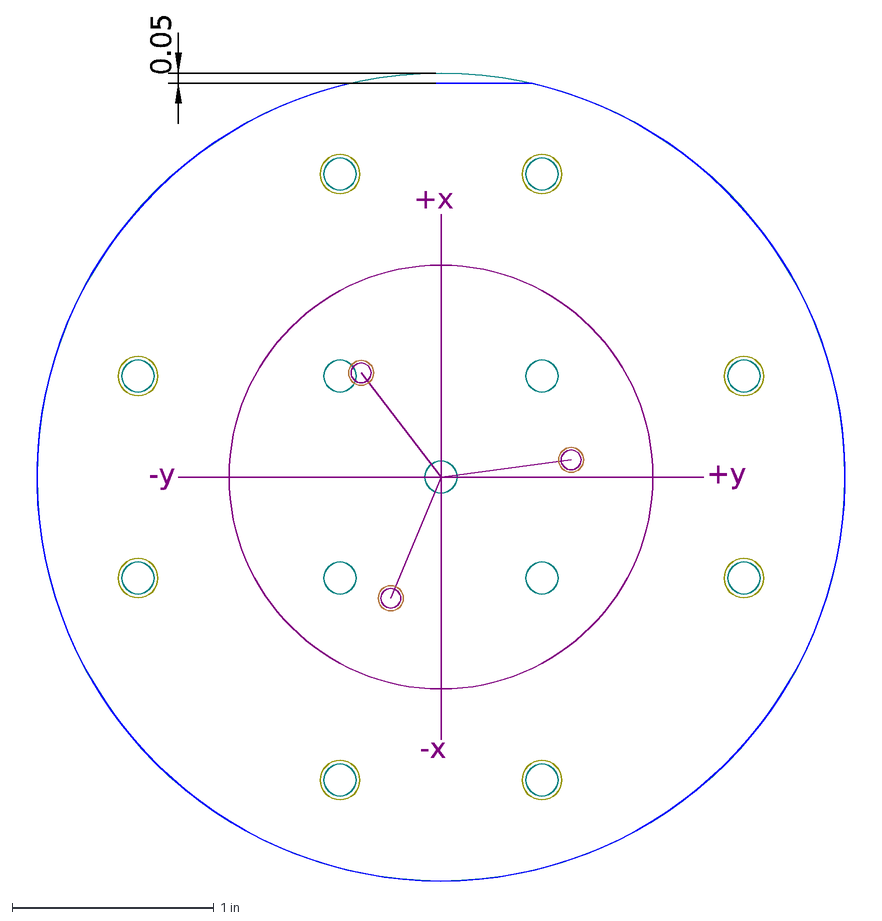
[picture p44: CAD file, 2016-07-18]
hardware/mechanics/gantry_parts/force_sensor_mount/force_sensor_to_tooling_plate.dxf
-x
+x
+y
-y
0.05
