iorodeo/noah_motion_system/hardware/mechanics/electronics_mount/main_plate/cable_tie_holder.dxf

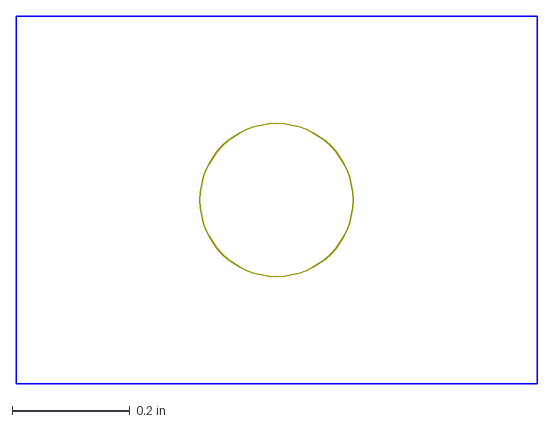
[picture p45: CAD file, 2016-07-25]
hardware/mechanics/electronics_mount/main_plate/cable_tie_holder.dxf
0.885 x 0.625 in
