iorodeo/noah_motion_system/hardware/mechanics/gantry_parts/carriage_mods/design_v2/upper_gantry_plate.dxf

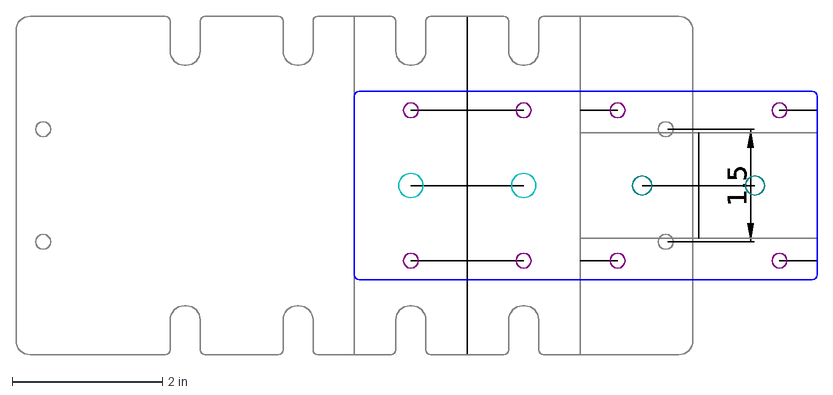
[picture p46: CAD file, 2016-06-23]
hardware/mechanics/gantry_parts/carriage_mods/design_v2/upper_gantry_plate.dxf
1.5
