iorodeo/noah_motion_system/hardware/mechanics/gantry_parts/force_sensor_mount/force_sensor_to_model_2_0p25-20.dxf

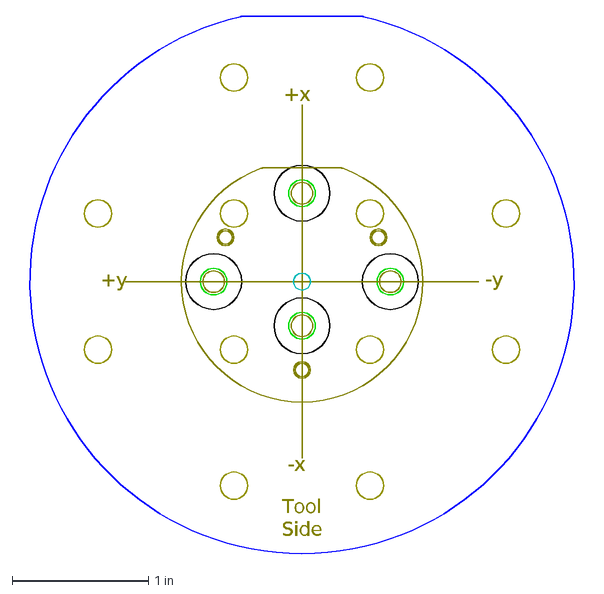
[picture p47: CAD file, 2016-07-18]
hardware/mechanics/gantry_parts/force_sensor_mount/force_sensor_to_model_2_0p25-20.dxf
-x
+x
Tool Side
+y
-y
