iorodeo/noah_motion_system/hardware/mechanics/gantry_parts/force_sensor_mount/force_sensor.dxf

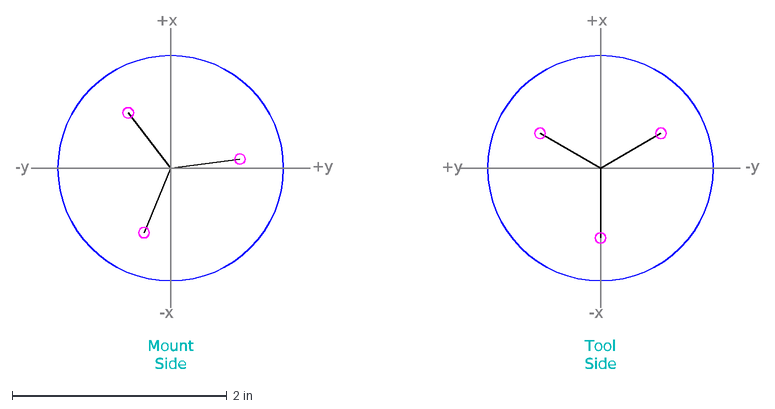
[picture p48: CAD file, 2016-07-16]
hardware/mechanics/gantry_parts/force_sensor_mount/force_sensor.dxf
Mount Side
-x
+x
+y
-y
Tool Side
