iorodeo/noah_motion_system/hardware/mechanics/gantry_parts/force_sensor_mount/sherline_toolling_plate.dxf

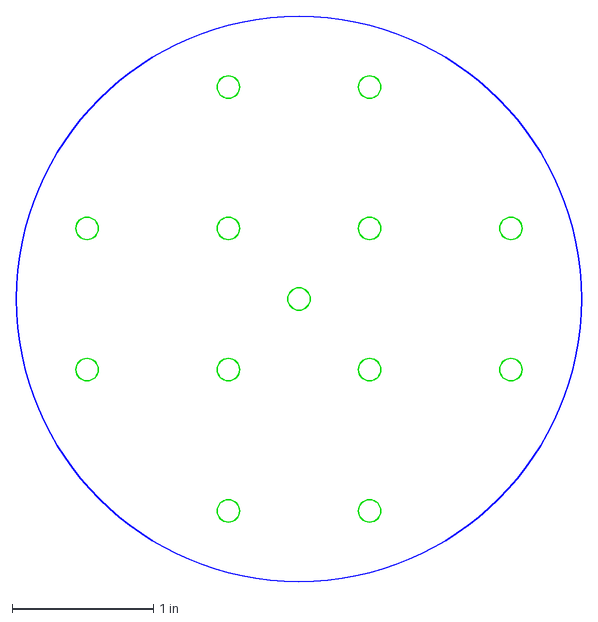
[picture p49: CAD file, 2016-07-16]
hardware/mechanics/gantry_parts/force_sensor_mount/sherline_toolling_plate.dxf
4.00 x 4.00 in
