iorodeo/noah_motion_system/(list of files, cad)

Other CAD files:
hardware/mechanics/electronics_mount/main_plate/main_plate.dxf
hardware/mechanics/electronics_mount/mdf_main_plate_backing/mdf_main_plate_backing.dxf
hardware/mechanics/electronics_mount/acrylic_cover_plates/main_plate.dxf
hardware/mechanics/gantry_mounting_frame/mdf_riser_blocks/upper_block.dxf
hardware/mechanics/electronics_mount/acrylic_cover_plates/lower_cover_plate.dxf
hardware/mechanics/electronics_mount/acrylic_cover_plates/upper_cover_plate.dxf
hardware/mechanics/electronics_mount/main_plate/cnc/main_plate.dxf
hardware/mechanics/gantry_parts/carriage_mods/design_v1/carriage_plate.dxf
hardware/mechanics/gantry_parts/carriage_mods/design_v1/gantry_plate.dxf
hardware/mechanics/gantry_parts/carriage_mods/design_v1/plate_assembly.dxf
hardware/mechanics/gantry_parts/limit_switch_mount/type2/carriage_switch_mount.dxf
hardware/mechanics/gantry_parts/limit_switch_mount/type2/vertical_axis_mount.dxf
