iorodeo/noah_motion_system/hardware/electronics/motion_controller/motion_controller.pdf

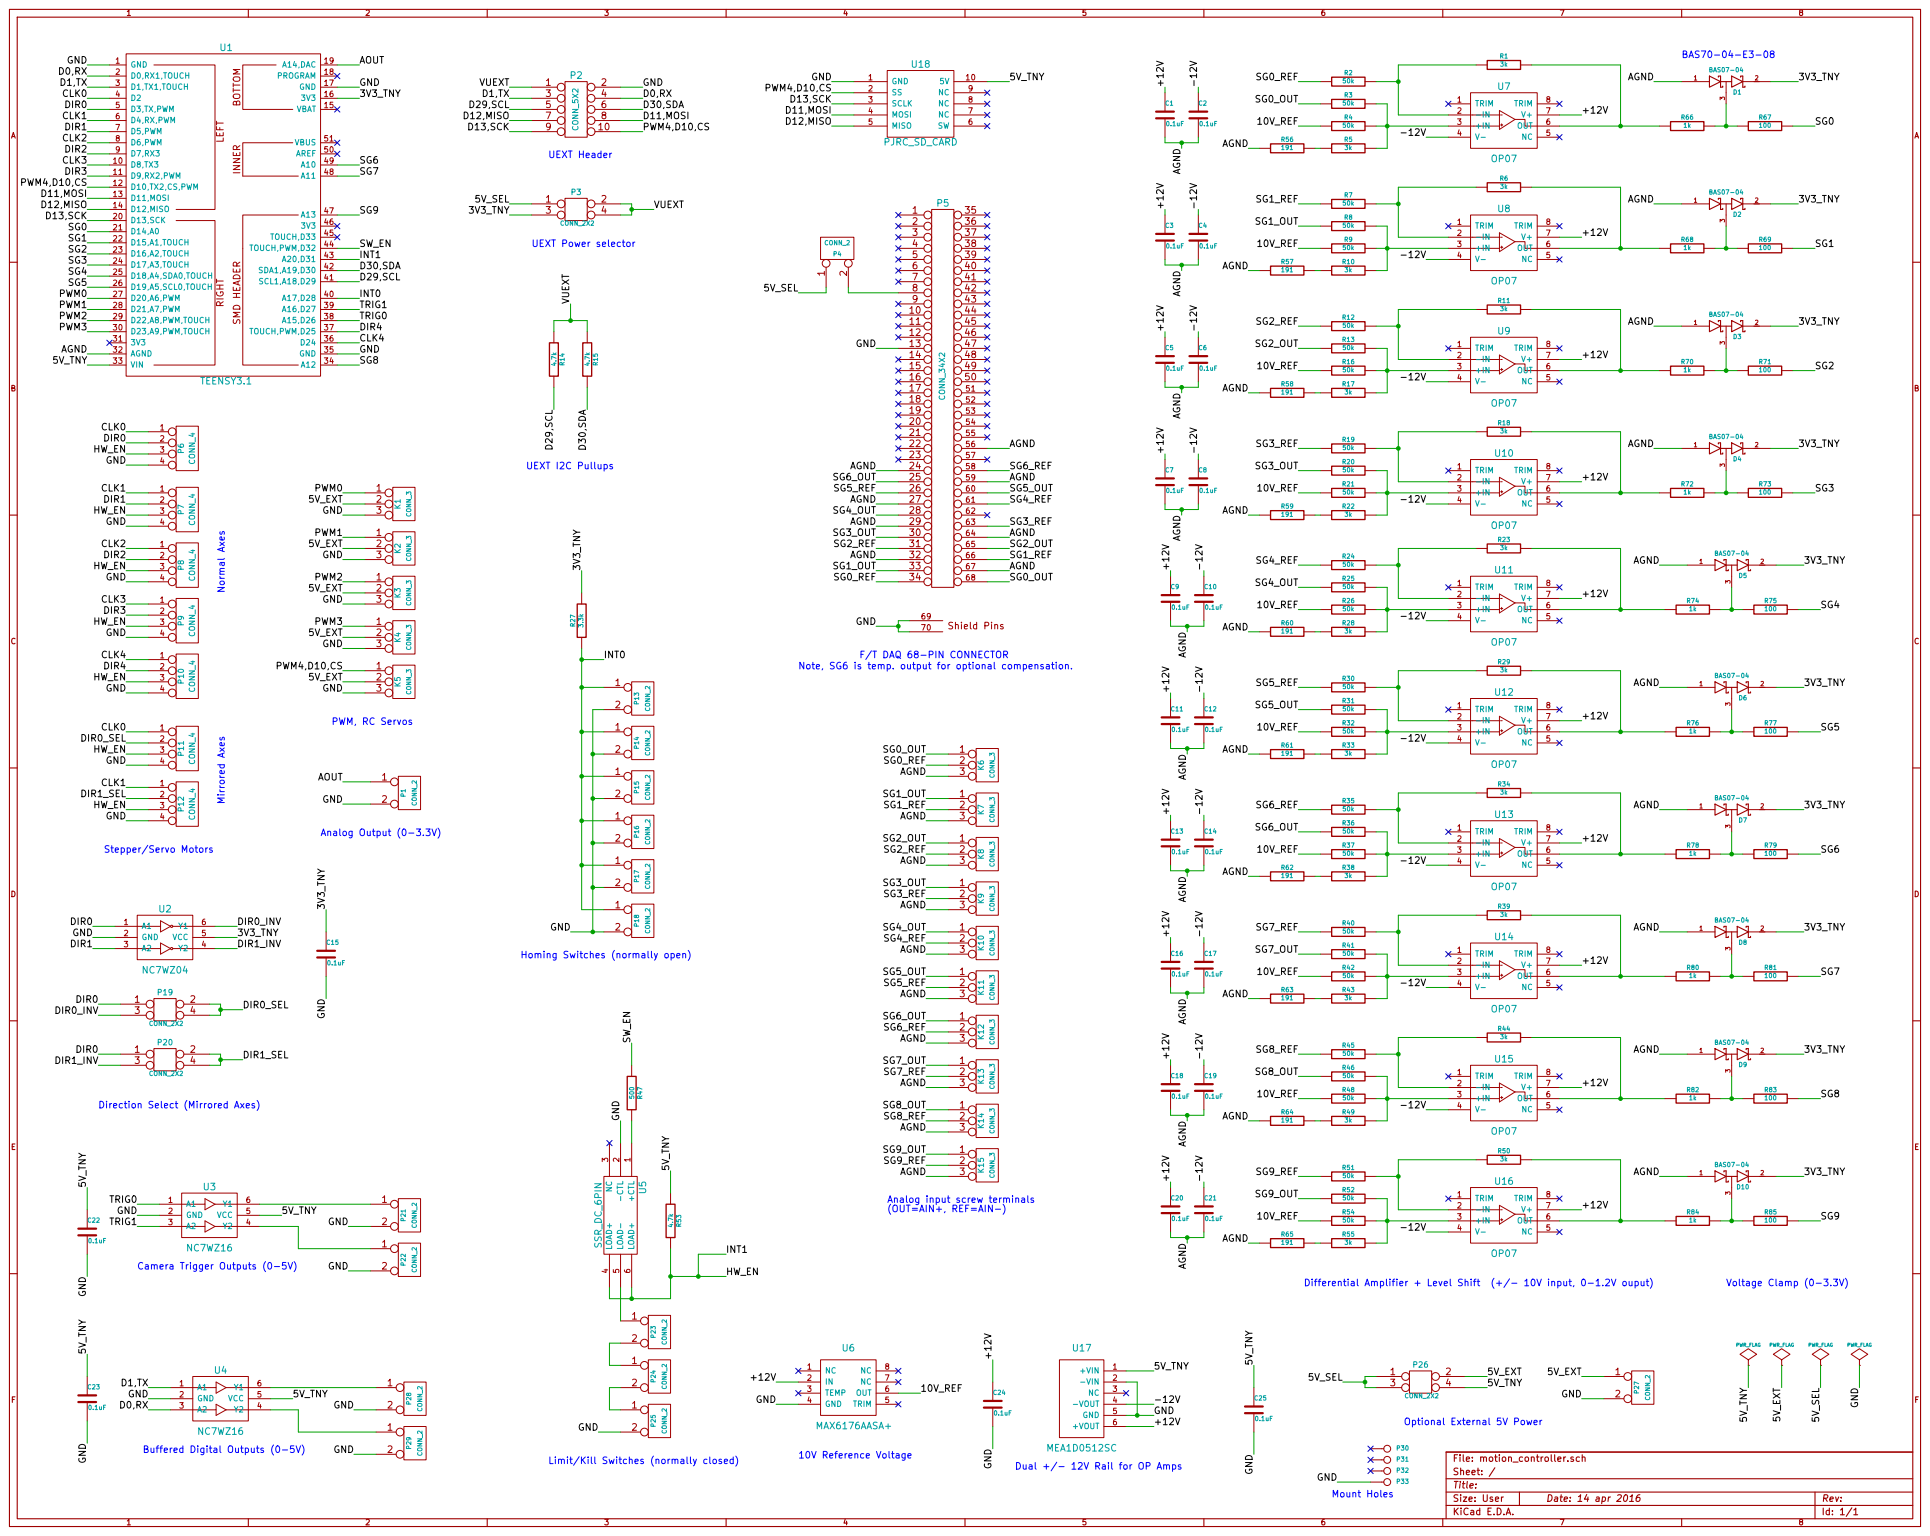
[picture p50: page 1]

Sheet: / BOTTOM INNER LEFT RIGHT SMD HEADER

Note, SG6 is temp. output for optional compensation.

Homing Switches (normally open)

Direction Select (Mirrored Axes)

Analog input screw terminals
(OUT=AIN+, REF=AIN-)

Differential Amplifier + Level Shift (+/- 10V input, 0-1.2V ouput)

+12V Dual +/- 12V Rail for OP Amps NC 1

Limit/Kill Switches (normally closed)

Id: 1/1 Title: File: motion_controller.sch
