iorodeo/noah_motion_system/(list of files, drawings)

Other design files:
hardware/electronics/motion_controller/motion_controller.dsn
