iorodeo/noah_motion_system/hardware/electronics/motion_controller/motion_controller.kicad_pcb

## KiCad design hardware/electronics/motion_controller/motion_controller.kicad_pcb (2016-04-14)

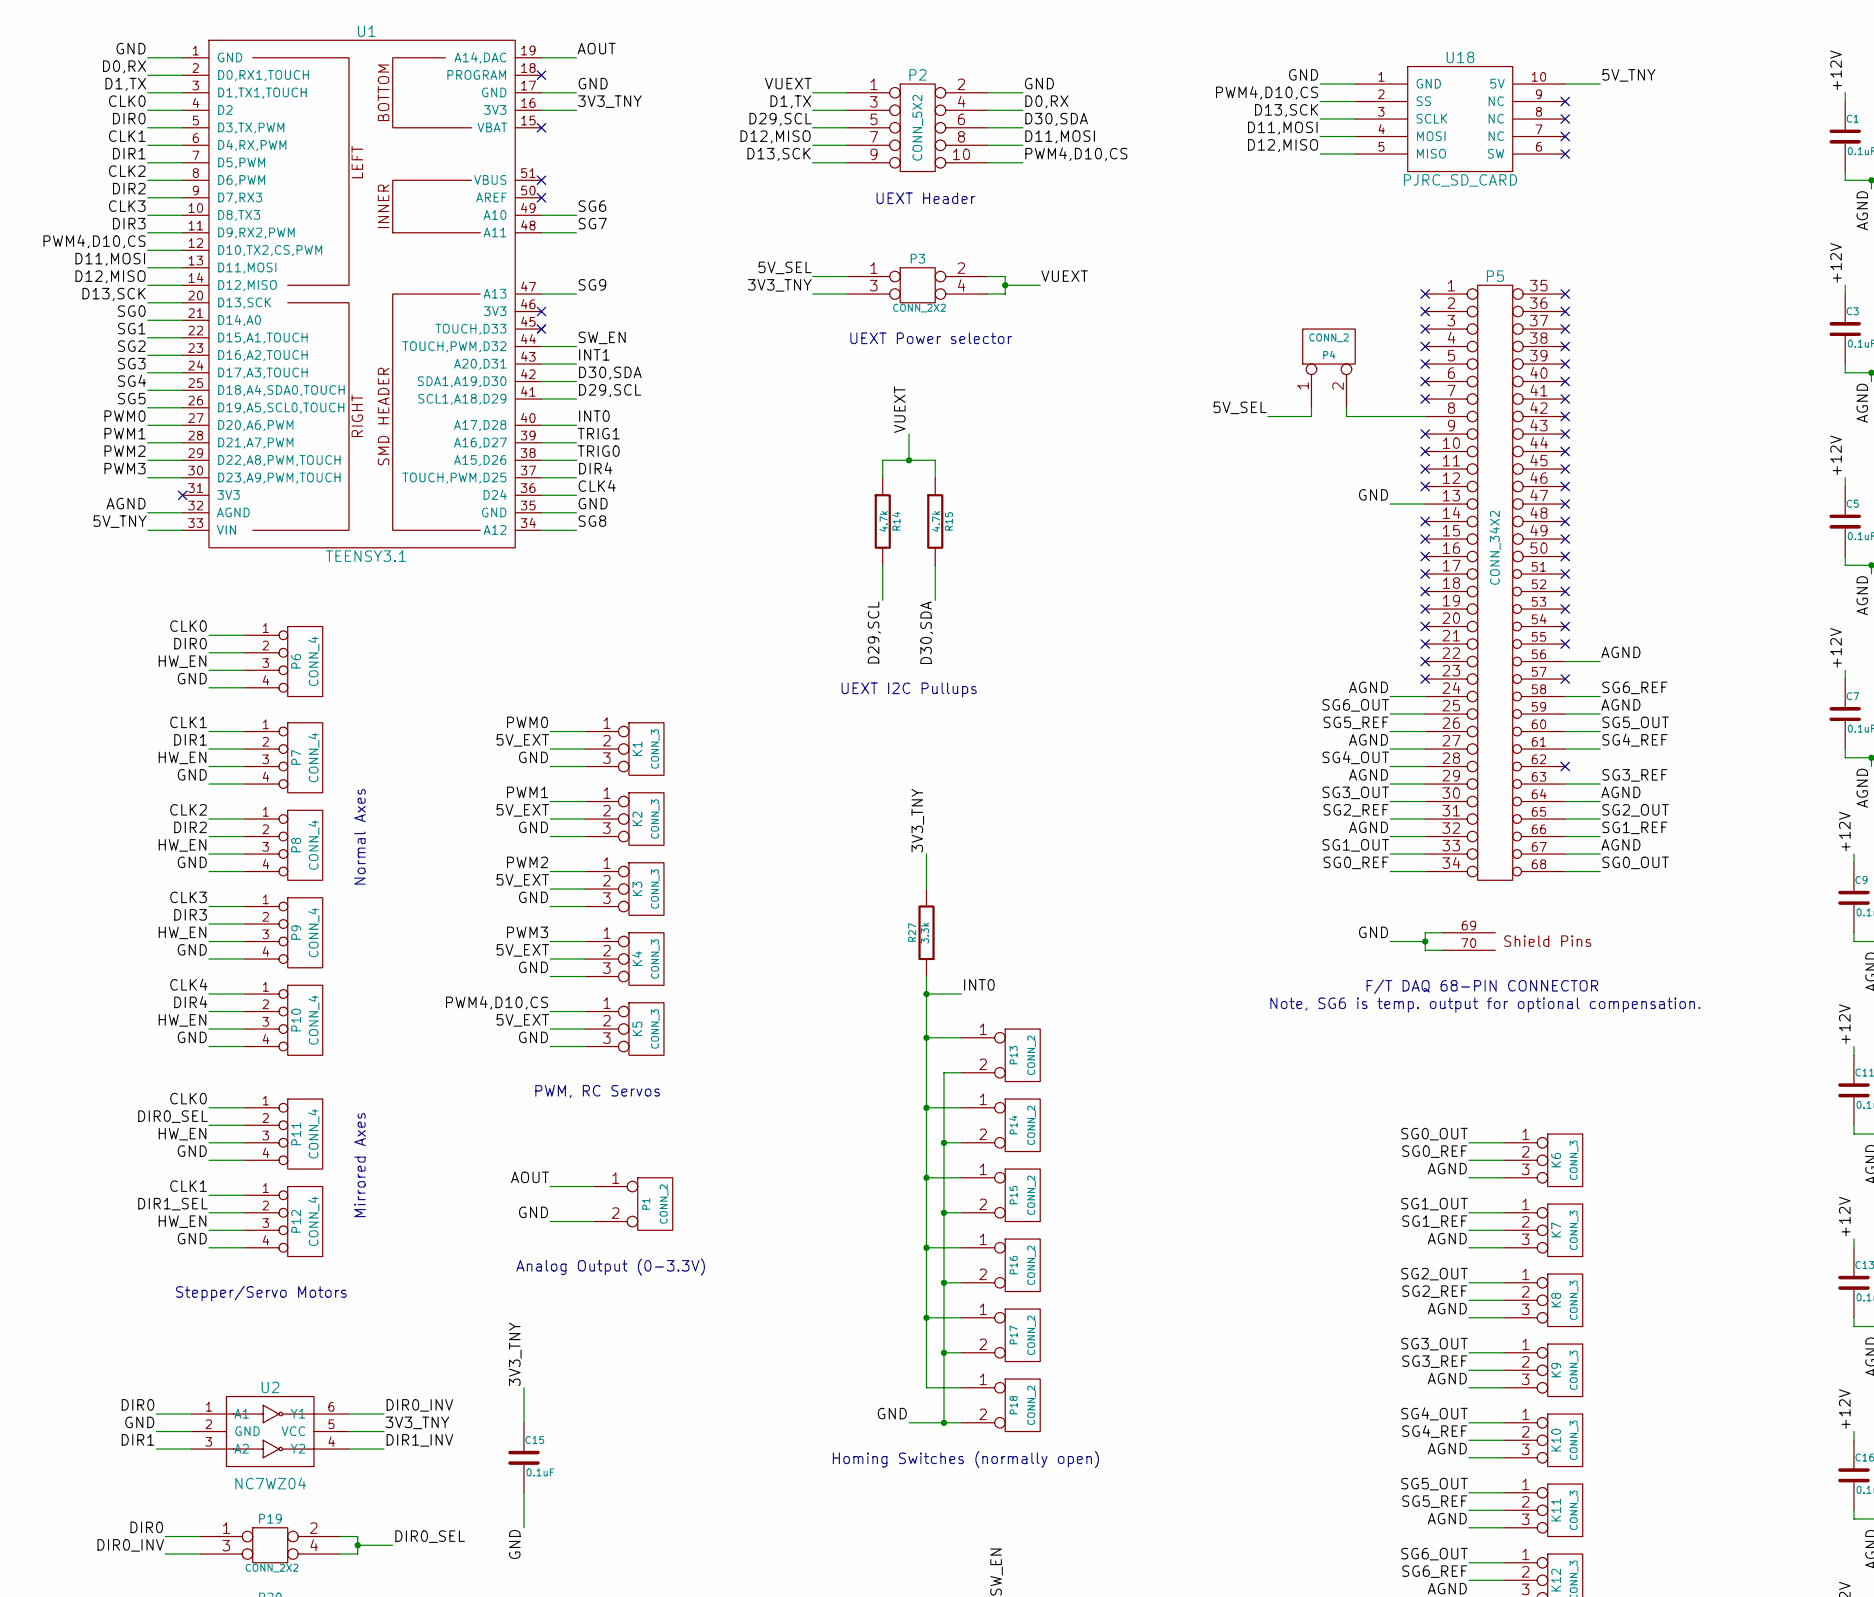
[picture p51: schematic motion_controller.sch, part in row 1, column 1]

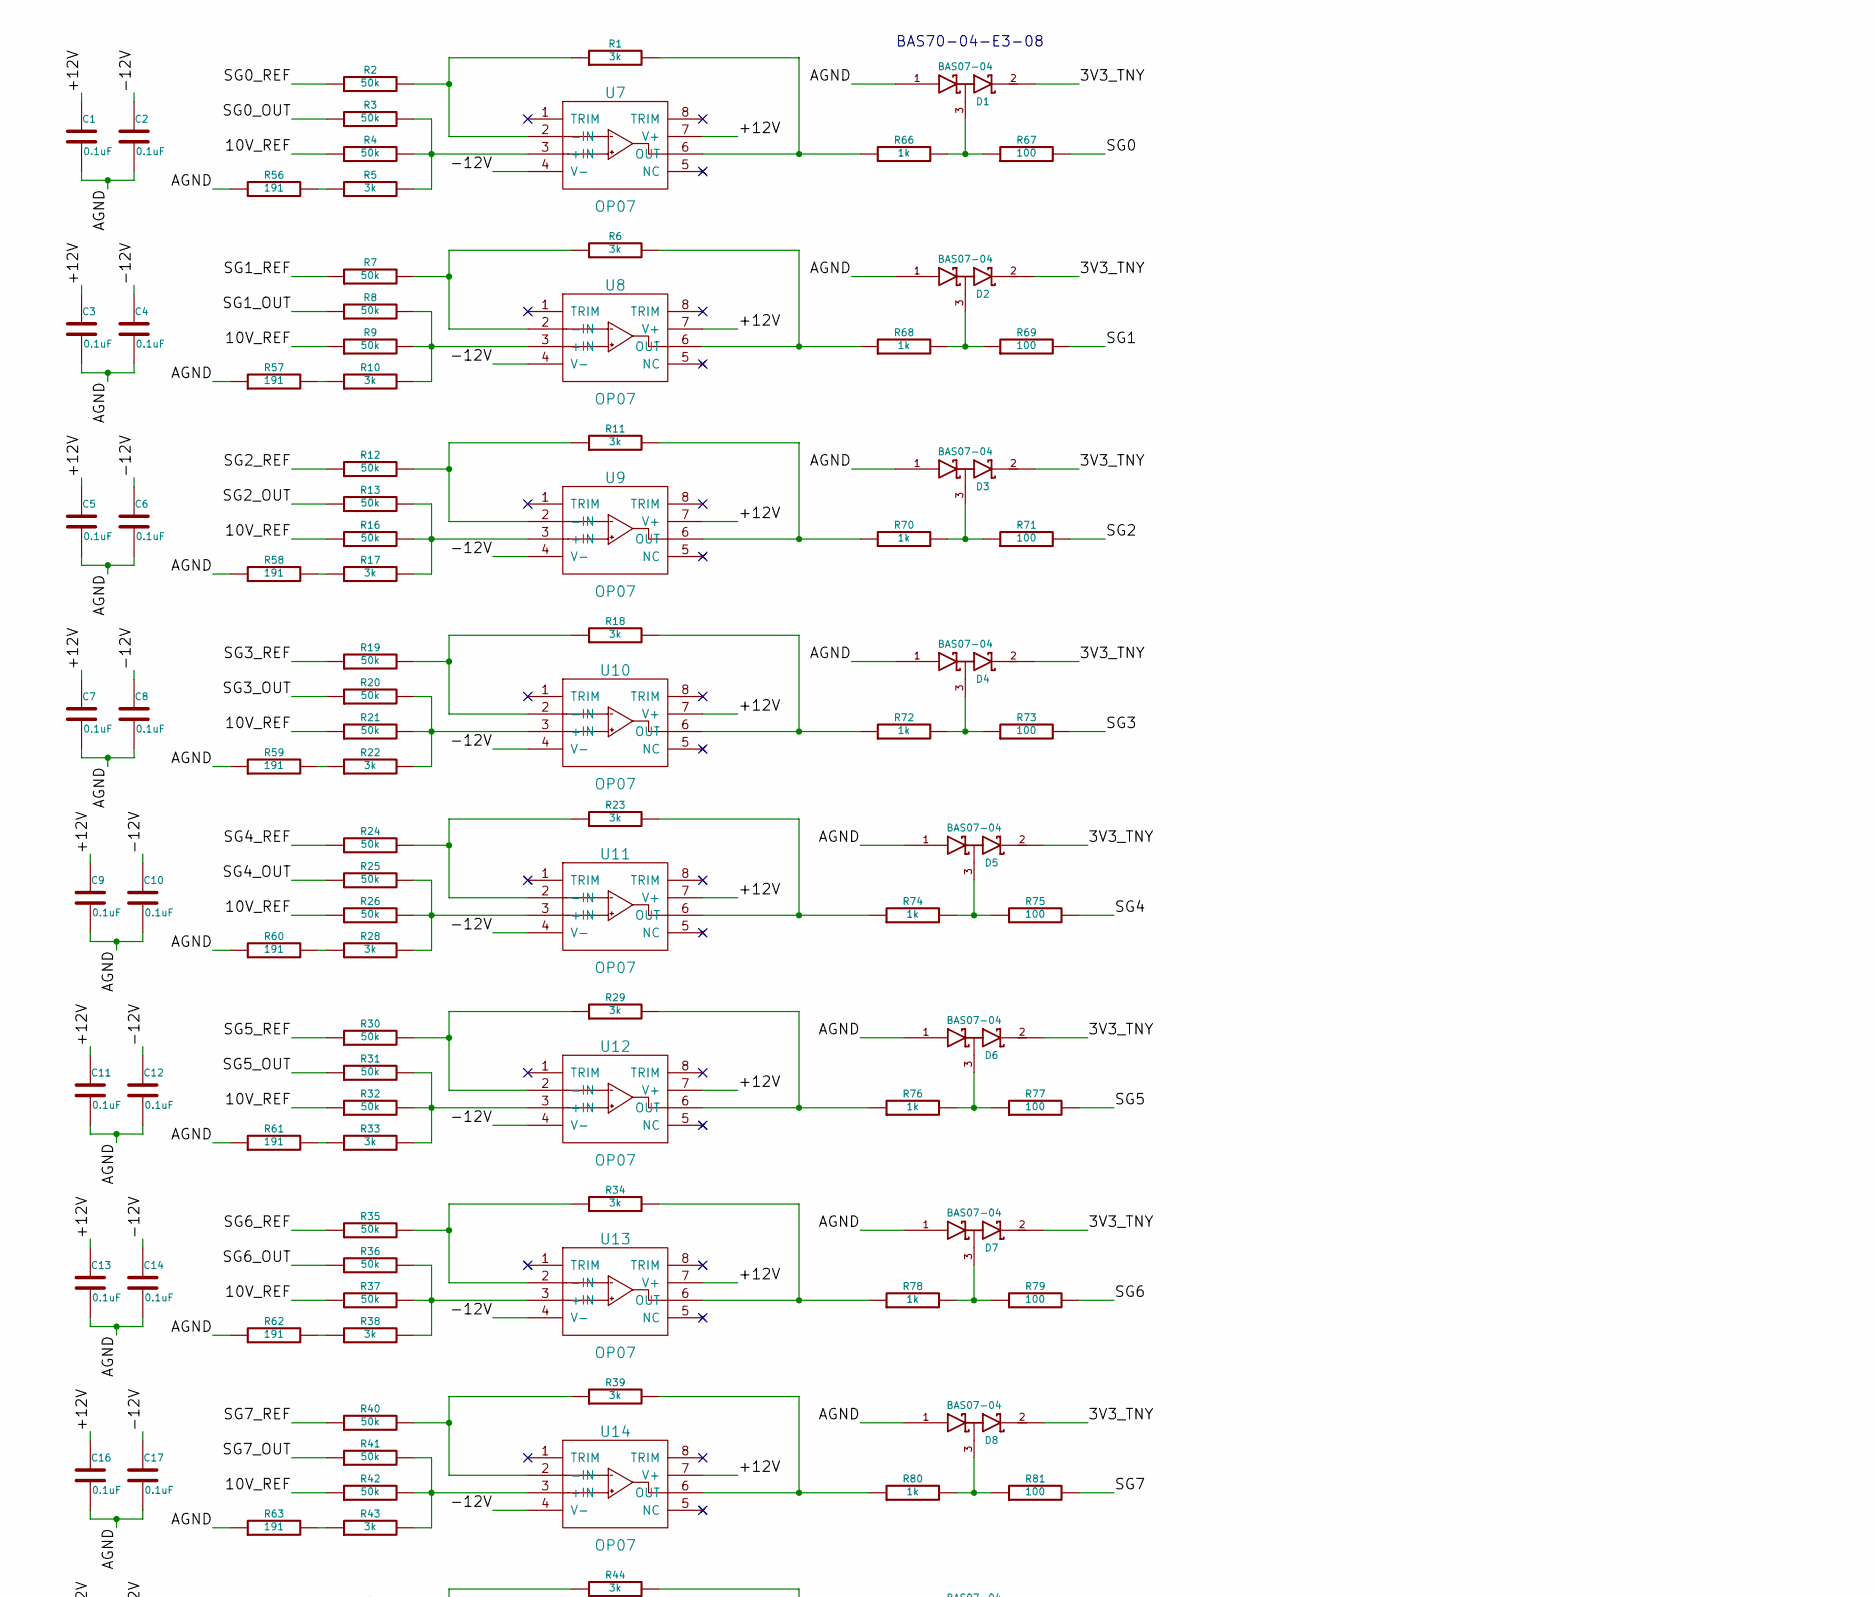
[picture p52: schematic motion_controller.sch, part in row 1, column 2]

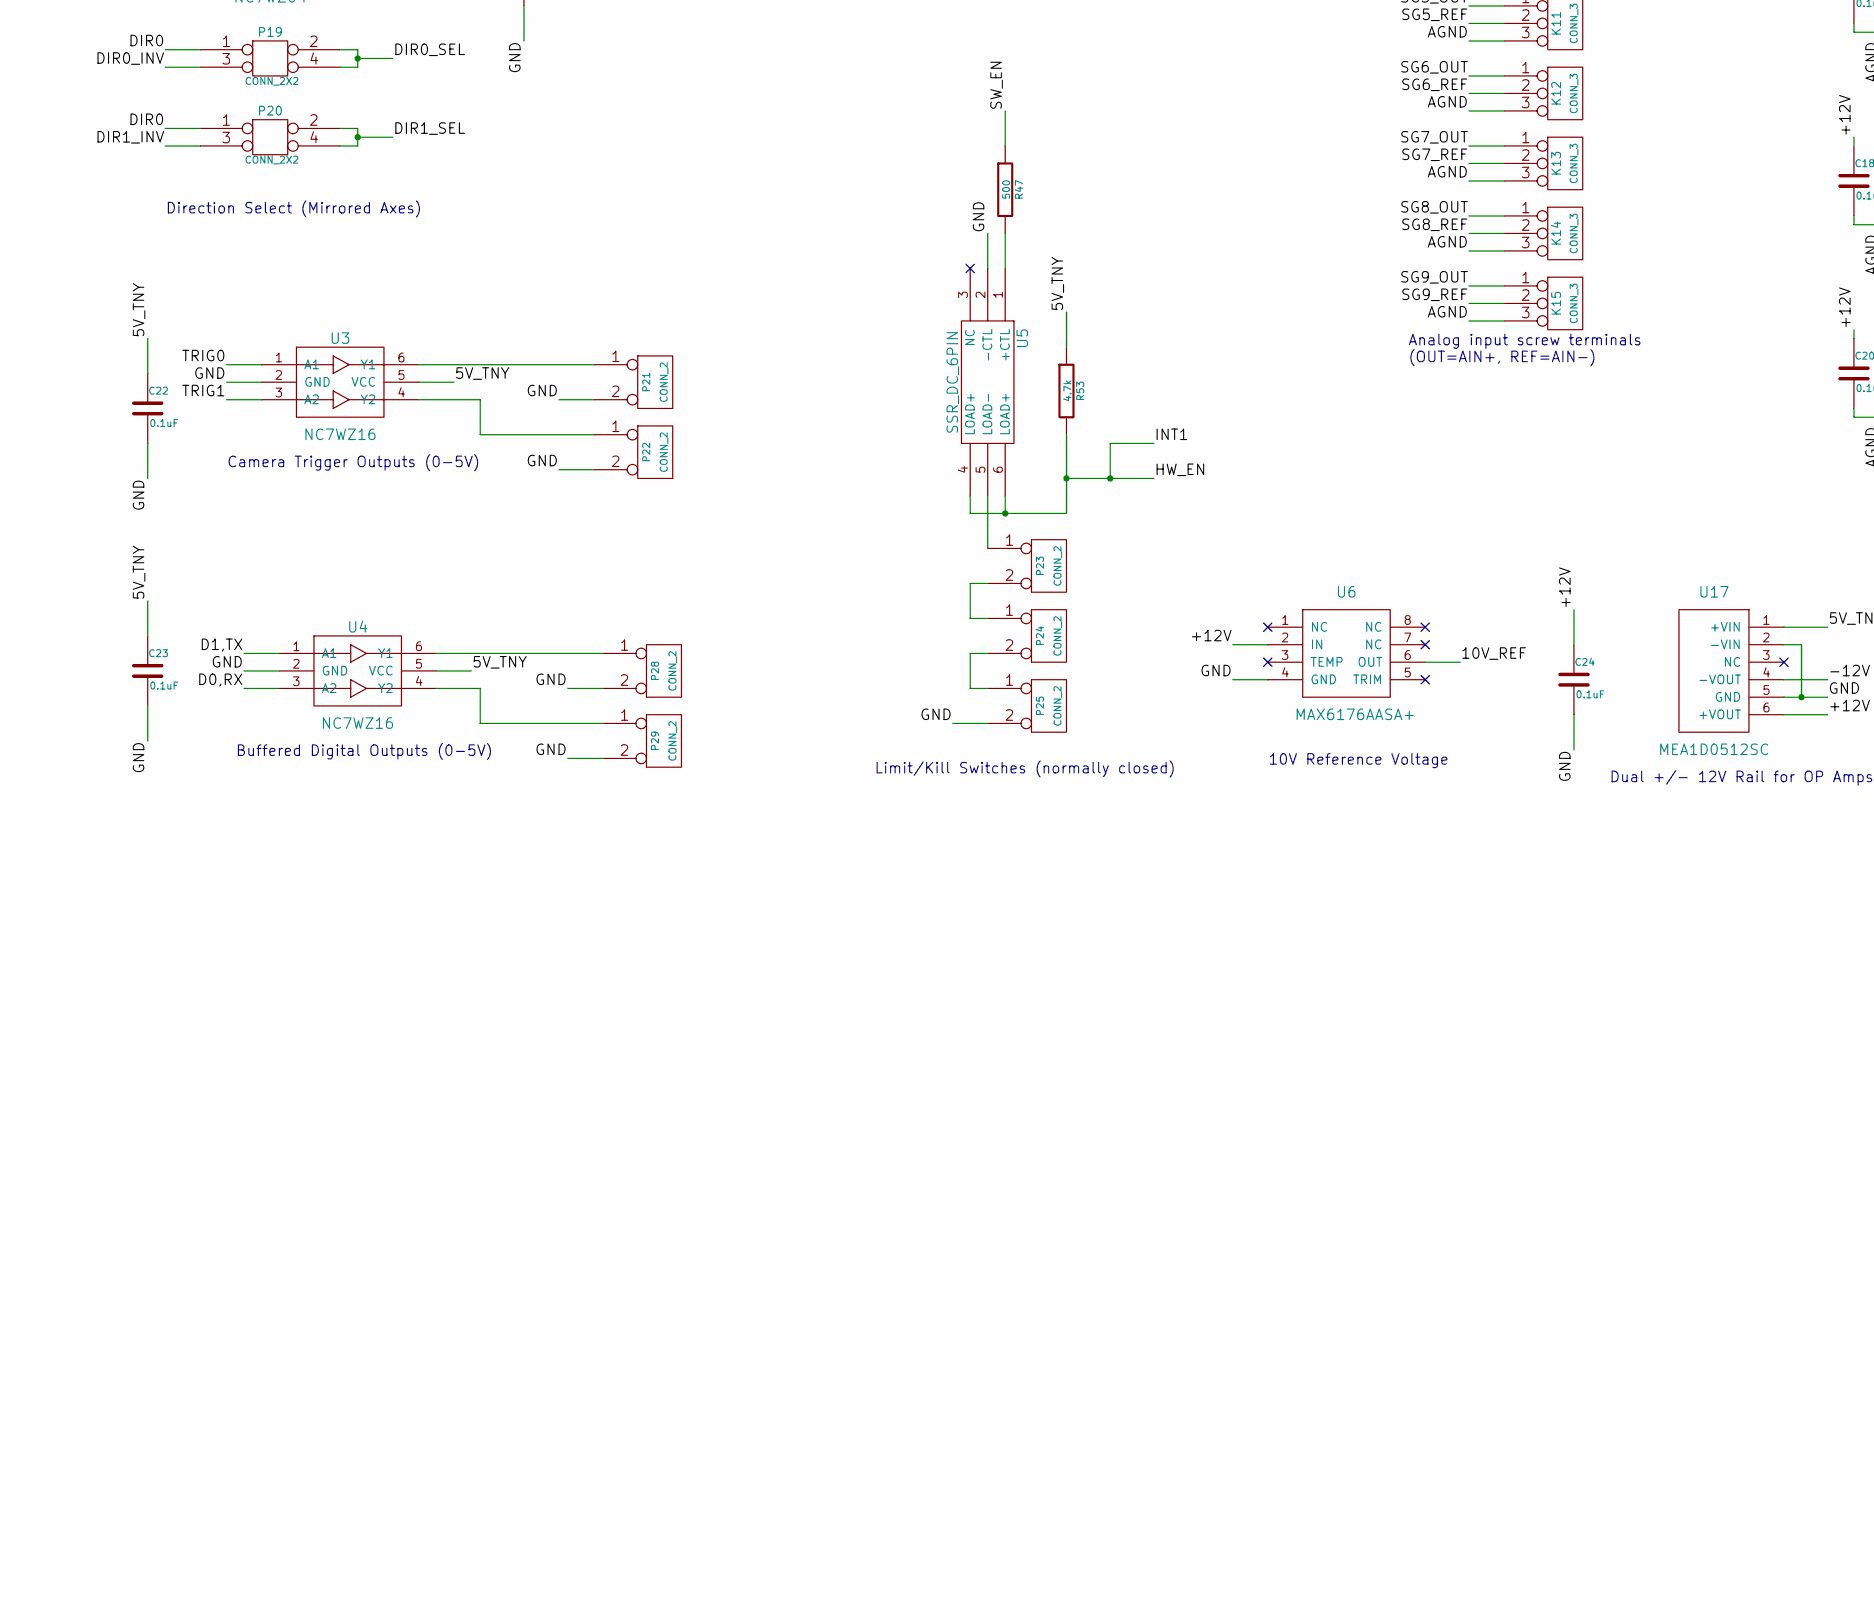
[picture p53: schematic motion_controller.sch, part in row 2, column 1]

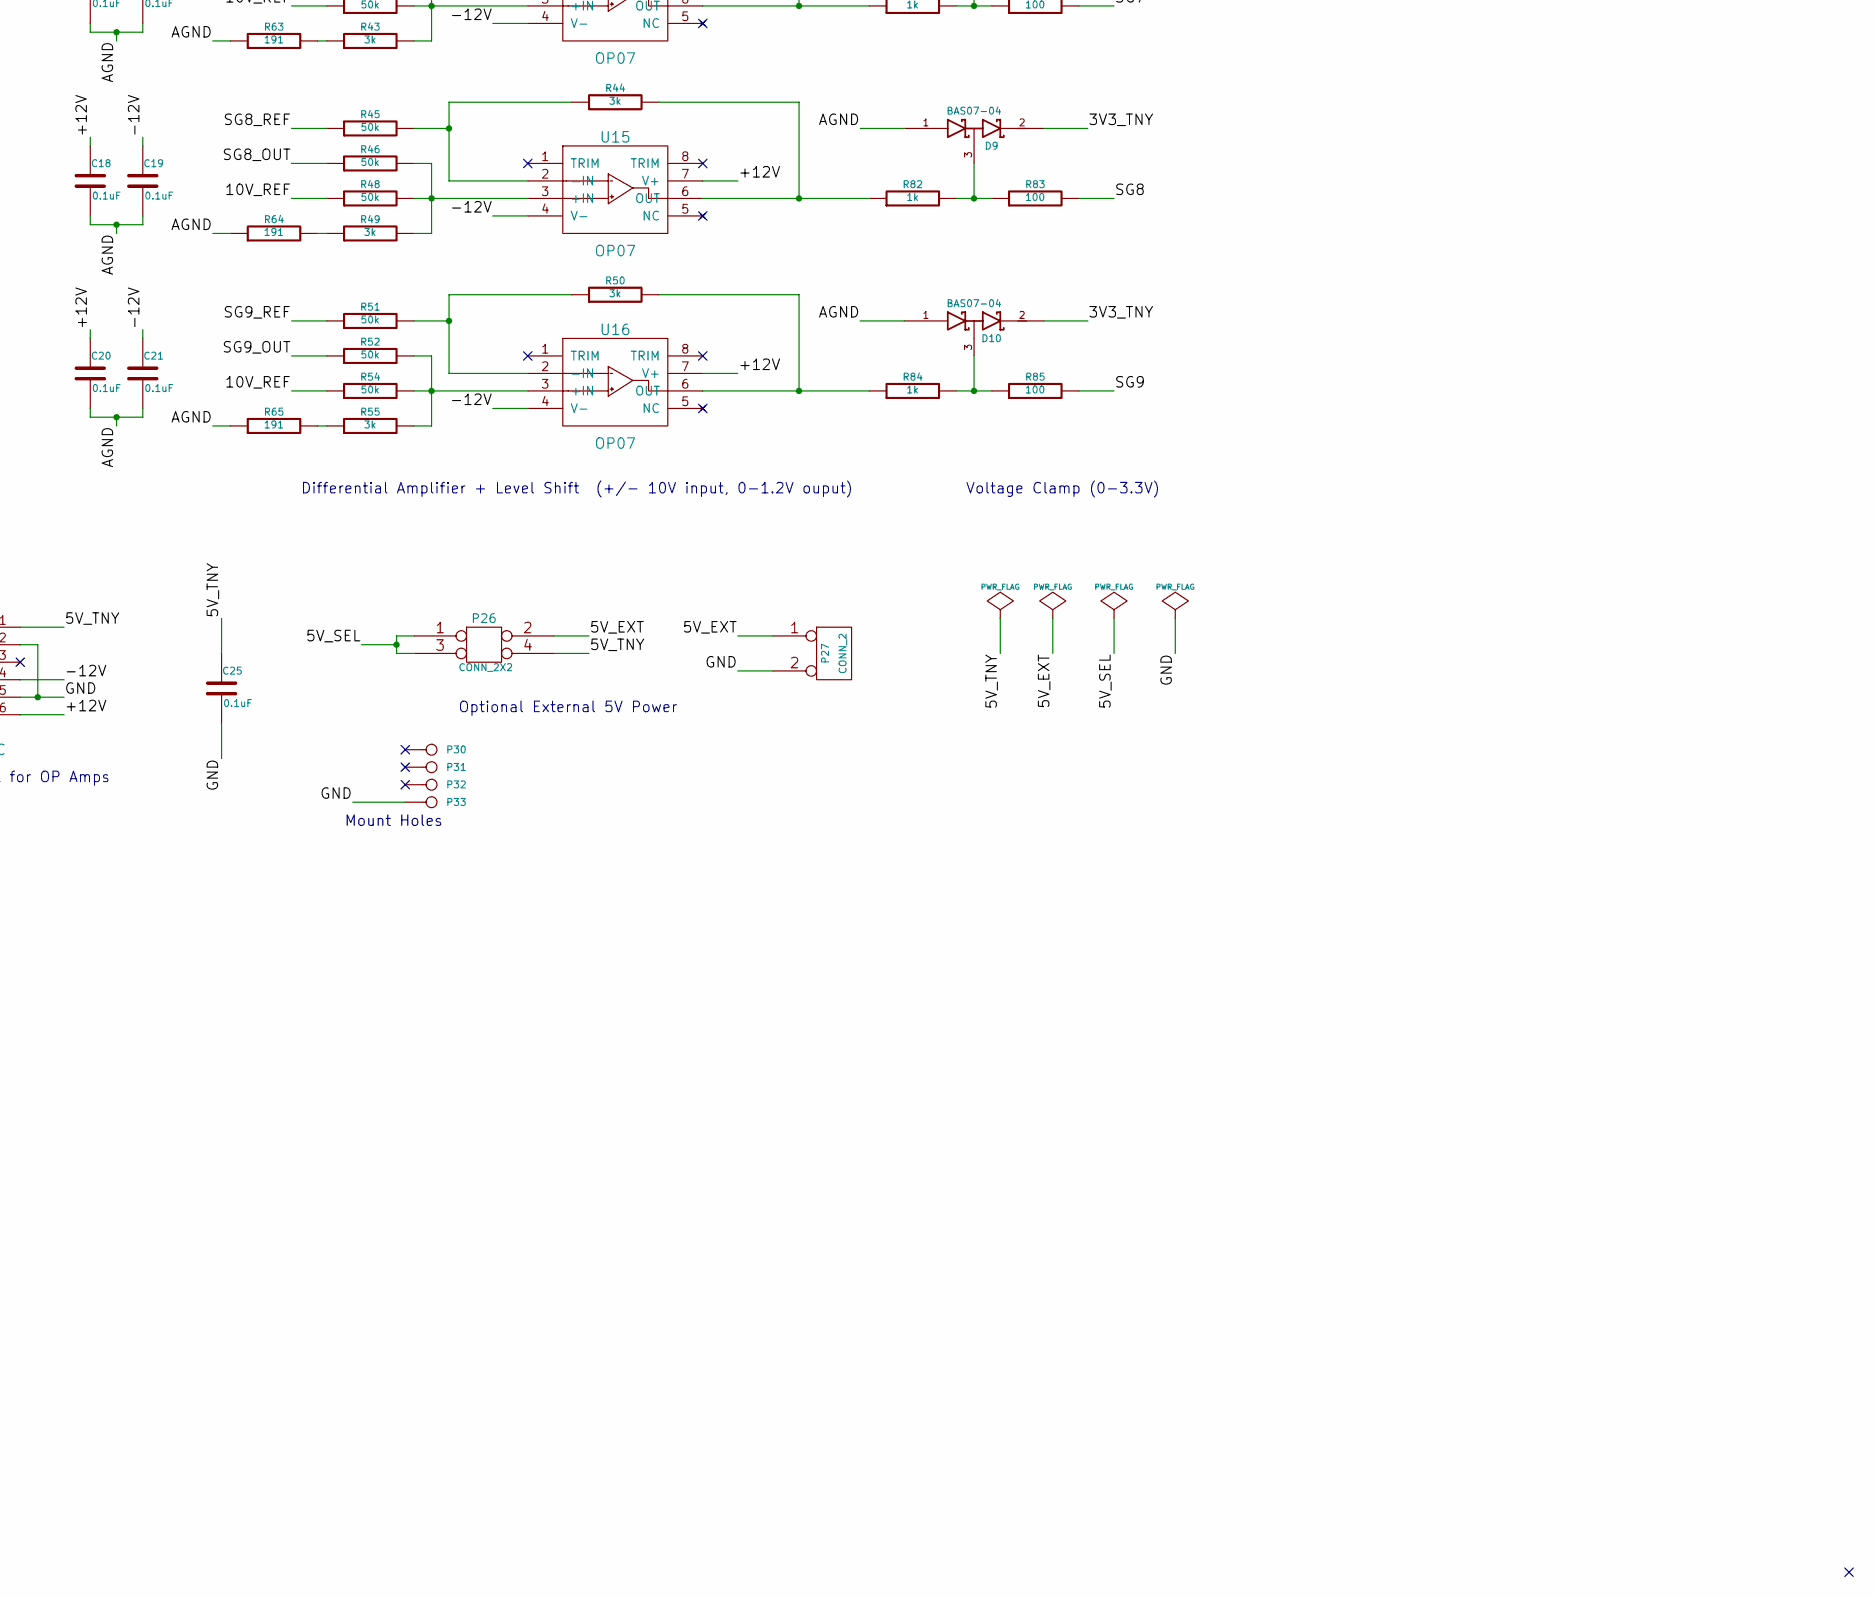
[picture p54: schematic motion_controller.sch, part in row 2, column 2]

Parts:
C1, C2, C3, C4, C5, C6, C7, C8, C9, C10, C11, C12, C13, C14, C15, C16, C17, C18, C19, C20, C21, C22, C23, C24, C25: 0.1uF
D1, D2, D3, D4, D5, D6, D7, D8, D9, D10: BAS07-04
K1, K2, K3, K4, K5, K6, K7, K8, K9, K10, K11, K12, K13, K14, K15: CONN_3
P1, P4, P13, P14, P15, P16, P17, P18, P21, P22, P23, P24, P25, P27, P28, P29: CONN_2
P2: CONN_5X2
P3, P19, P20, P26: CONN_2X2
P5: CONN_34X2
P6, P7, P8, P9, P10, P11, P12: CONN_4
P30, P31, P32, P33: CONN_1
R1, R5, R6, R10, R11, R17, R18, R22, R23, R28, R29, R33, R34, R38, R39, R43, R44, R49, R50, R55: 3k
R2, R3, R4, R7, R8, R9, R12, R13, R16, R19, R20, R21, R24, R25, R26, R30, R31, R32, R35, R36, R37, R40, R41, R42, R45, R46, R48, R51, R52, R54: 50k
R14, R15, R53: 4.7k
R27: 3.3k
R47: 500
R56, R57, R58, R59, R60, R61, R62, R63, R64, R65: 191
R66, R68, R70, R72, R74, R76, R78, R80, R82, R84: 1k
R67, R69, R71, R73, R75, R77, R79, R81, R83, R85: 100
U1: TEENSY3.1
U2: NC7WZ04
U3, U4: NC7WZ16
U5: SSR_DC_6PIN
U6: MAX6176AASA+
U7, U8, U9, U10, U11, U12, U13, U14, U15, U16: OP07
U17: MEA1D0512SC
U18: PJRC_SD_CARD

Connections:
/3V3_TNY: C15.1, D1.2 (cathode), D2.2 (cathode), D3.2 (cathode), D4.2 (cathode), D5.2 (cathode), D6.2 (cathode), D7.2 (cathode), D8.2 (cathode), D9.2 (cathode), D10.2 (cathode), P3.3, R27.2, U1.16 (3V3), U2.5 (VCC)
/5V_EXT: K1.2 (PM), K2.2 (PM), K3.2 (PM), K4.2 (PM), K5.2 (PM), P26.2, P27.1
/5V_SEL: P3.1, P4.1, P26.1, P26.3
/5V_TNY: C22.1, C23.1, C25.1, P26.4, R53.1, U1.33 (VIN), U3.5 (VCC), U4.5 (VCC), U17.1 (+VIN), U18.10 (5V)
/10V_REF: R4.1, R9.1, R16.1, R21.1, R26.1, R32.1, R37.1, R42.1, R48.1, R54.1, U6.6 (OUT)
/+12V: C1.1, C3.1, C5.1, C7.1, C9.1, C11.1, C13.1, C16.1, C18.1, C20.1, C24.1, U6.2 (IN), U7.7 (V+), U8.7 (V+), U9.7 (V+), U10.7 (V+), U11.7 (V+), U12.7 (V+), U13.7 (V+), U14.7 (V+), U15.7 (V+), U16.7 (V+), U17.6 (+VOUT)
/-12V: C2.1, C4.1, C6.1, C8.1, C10.1, C12.1, C14.1, C17.1, C19.1, C21.1, U7.4 (V-), U8.4 (V-), U9.4 (V-), U10.4 (V-), U11.4 (V-), U12.4 (V-), U13.4 (V-), U14.4 (V-), U15.4 (V-), U16.4 (V-), U17.4 (-VOUT)
/AGND: C1.2, C2.2, C3.2, C4.2, C5.2, C6.2, C7.2, C8.2, C9.2, C10.2, C11.2, C12.2, C13.2, C14.2, C16.2, C17.2, C18.2, C19.2, C20.2, C21.2, D1.1 (Anode), D2.1 (Anode), D3.1 (Anode), D4.1 (Anode), D5.1 (Anode), D6.1 (Anode), D7.1 (Anode), D8.1 (Anode), D9.1 (Anode), D10.1 (Anode), K6.3, K7.3, K8.3, K9.3, K10.3, K11.3, K12.3, K13.3, K14.3, K15.3, P5.24, P5.27, P5.29, P5.32, P5.56, P5.59, P5.64, P5.67, R56.1, R57.1, R58.1, R59.1, R60.1, R61.1, R62.1, R63.1, R64.1, R65.1, U1.32 (AGND)
/AOUT: P1.1, U1.19 (A14,DAC)
/CLK0: P6.1, P11.1, U1.4 (D2)
/CLK1: P7.1, P12.1, U1.6 (D4,RX,PWM)
/CLK2: P8.1, U1.8 (D6,PWM)
/CLK3: P9.1, U1.10 (D8,TX3)
/CLK4: P10.1, U1.36 (D24)
/D0,RX: P2.4, U1.2 (D0,RX1,TOUCH), U4.3 (A2)
/D1,TX: P2.3, U1.3 (D1,TX1,TOUCH), U4.1 (A1)
/D11,MOSI: P2.8, U1.13 (D11,MOSI), U18.4 (MOSI)
/D12,MISO: P2.7, U1.14 (D12,MISO), U18.5 (MISO)
/D13,SCK: P2.9, U1.20 (D13,SCK), U18.3 (SCLK)
/D29,SCL: P2.5, R14.2, U1.41 (SCL1,A18,D29)
/D30,SDA: P2.6, R15.2, U1.42 (SDA1,A19,D30)
/DIR0: P6.2, P19.1, P20.1, U1.5 (D3,TX,PWM), U2.1 (A1)
/DIR0_INV: P19.3, U2.6 (Y1)
/DIR0_SEL: P11.2, P19.2, P19.4
/DIR1: P7.2, U1.7 (D5,PWM), U2.3 (A2)
/DIR1_INV: P20.3, U2.4 (Y2)
/DIR1_SEL: P12.2, P20.2, P20.4
/DIR2: P8.2, U1.9 (D7,RX3)
/DIR3: P9.2, U1.11 (D9,RX2,PWM)
/DIR4: P10.2, U1.37 (TOUCH,PWM,D25)
/GND: C15.2, C22.2, C23.2, C24.2, C25.2, K1.3, K2.3, K3.3, K4.3, K5.3, P1.2 (PM), P2.2, P5.13, P5.69, P5.70, P6.4, P7.4, P8.4, P9.4, P10.4, P11.4, P12.4, P13.2 (PM), P14.2 (PM), P15.2 (PM), P16.2 (PM), P17.2 (PM), P18.2 (PM), P21.2 (PM), P22.2 (PM), P25.2 (PM), P27.2 (PM), P28.2 (PM), P29.2 (PM), P33.1, U1.1 (GND), U1.17 (GND), U1.35 (GND), U2.2 (GND), U3.2 (GND), U4.2 (GND), U5.2 (-CTL), U6.4 (GND), U17.2 (-VIN), U17.5 (GND), U18.1 (GND)
/HW_EN: P6.3, P7.3, P8.3, P9.3, P10.3, P11.3, P12.3, R53.2, U1.43 (A20,D31), U5.4 (LOAD+), U5.6 (LOAD+)
/INT0: P13.1, P14.1, P15.1, P16.1, P17.1, P18.1, R27.1, U1.40 (A17,D28)
/PWM0: K1.1, U1.27 (D20,A6,PWM)
/PWM1: K2.1, U1.28 (D21,A7,PWM)
/PWM2: K3.1, U1.29 (D22,A8,PWM,TOUCH)
/PWM3: K4.1, U1.30 (D23,A9,PWM,TOUCH)
/PWM4,D10,CS: K5.1, P2.10, U1.12 (D10,TX2,CS,PWM), U18.2 (SS)
/SG0: R67.2, U1.21 (D14,A0)
/SG0_OUT: K6.1, P5.68, R3.1
/SG0_REF: K6.2 (PM), P5.34, R2.1
/SG1: R69.2, U1.22 (D15,A1,TOUCH)
/SG1_OUT: K7.1, P5.33, R8.1
/SG1_REF: K7.2 (PM), P5.66, R7.1
/SG2: R71.2, U1.23 (D16,A2,TOUCH)
/SG2_OUT: K8.1, P5.65, R13.1
/SG2_REF: K8.2 (PM), P5.31, R12.1
/SG3: R73.2, U1.24 (D17,A3,TOUCH)
/SG3_OUT: K9.1, P5.30, R20.1
/SG3_REF: K9.2 (PM), P5.63, R19.1
/SG4: R75.2, U1.25 (D18,A4,SDA0,TOUCH)
/SG4_OUT: K10.1, P5.28, R25.1
/SG4_REF: K10.2 (PM), P5.61, R24.1
/SG5: R77.2, U1.26 (D19,A5,SCL0,TOUCH)
/SG5_OUT: K11.1, P5.60, R31.1
/SG5_REF: K11.2 (PM), P5.26, R30.1
/SG6: R79.2, U1.49 (A10)
/SG6_OUT: K12.1, P5.25, R36.1
/SG6_REF: K12.2 (PM), P5.58, R35.1
/SG7: R81.2, U1.48 (A11)
/SG7_OUT: K13.1, R41.1
/SG7_REF: K13.2 (PM), R40.1
/SG8: R83.2, U1.34 (A12)
/SG8_OUT: K14.1, R46.1
/SG8_REF: K14.2 (PM), R45.1
/SG9: R85.2, U1.47 (A13)
/SG9_OUT: K15.1, R52.1
/SG9_REF: K15.2 (PM), R51.1
/SW_EN: R47.1, U1.44 (TOUCH,PWM,D32)
/TRIG0: U1.38 (A15,D26), U3.1 (A1)
/TRIG1: U1.39 (A16,D27), U3.3 (A2)
/VUEXT: P2.1, P3.2, P3.4, R14.1, R15.1
unnamed: P21.1, U3.6 (Y1)
unnamed: R47.2, U5.1 (+CTL)
unnamed: P23.1, U5.5 (LOAD-)
unnamed: P29.1, U4.4 (Y2)
unnamed: P28.1, U4.6 (Y1)
unnamed: P22.1, U3.4 (Y2)
unnamed: P23.2 (PM), P24.1
unnamed: P24.2 (PM), P25.1
unnamed: R20.2, R21.2, R22.2, U10.3 (+IN)
unnamed: R18.2, R72.1, U10.6 (OUT)
unnamed: R18.1, R19.2, U10.2 (-IN)
unnamed: R13.2, R16.2, R17.2, U9.3 (+IN)
unnamed: R11.2, R70.1, U9.6 (OUT)
unnamed: R29.2, R76.1, U12.6 (OUT)
unnamed: R25.2, R26.2, R28.2, U11.3 (+IN)
unnamed: R23.2, R74.1, U11.6 (OUT)
unnamed: R23.1, R24.2, U11.2 (-IN)
unnamed: R1.2, R66.1, U7.6 (OUT)
unnamed: R1.1, R2.2, U7.2 (-IN)
unnamed: R11.1, R12.2, U9.2 (-IN)
unnamed: R8.2, R9.2, R10.2, U8.3 (+IN)
unnamed: R6.2, R68.1, U8.6 (OUT)
unnamed: R6.1, R7.2, U8.2 (-IN)
unnamed: R3.2, R4.2, R5.2, U7.3 (+IN)
unnamed: R33.1, R61.2
unnamed: R49.1, R64.2
unnamed: R43.1, R63.2
unnamed: R38.1, R62.2
unnamed: R28.1, R60.2
unnamed: R22.1, R59.2
unnamed: R17.1, R58.2
unnamed: R10.1, R57.2
unnamed: P4.2 (PM), P5.8
unnamed: D1.3 (AK), R66.2, R67.1
unnamed: R55.1, R65.2
unnamed: R50.1, R51.2, U16.2 (-IN)
unnamed: R5.1, R56.2
unnamed: D4.3 (AK), R72.2, R73.1
unnamed: D3.3 (AK), R70.2, R71.1
unnamed: D6.3 (AK), R76.2, R77.1
unnamed: D5.3 (AK), R74.2, R75.1
unnamed: D2.3 (AK), R68.2, R69.1
unnamed: R34.2, R78.1, U13.6 (OUT)
unnamed: D10.3 (AK), R84.2, R85.1
unnamed: D8.3 (AK), R80.2, R81.1
unnamed: R39.2, R80.1, U14.6 (OUT)
unnamed: D7.3 (AK), R78.2, R79.1
unnamed: D9.3 (AK), R82.2, R83.1
unnamed: R50.2, R84.1, U16.6 (OUT)
unnamed: R44.2, R82.1, U15.6 (OUT)
unnamed: R46.2, R48.2, R49.2, U15.3 (+IN)
unnamed: R36.2, R37.2, R38.2, U13.3 (+IN)
unnamed: R34.1, R35.2, U13.2 (-IN)
unnamed: R31.2, R32.2, R33.2, U12.3 (+IN)
unnamed: R29.1, R30.2, U12.2 (-IN)
unnamed: R41.2, R42.2, R43.2, U14.3 (+IN)
unnamed: R44.1, R45.2, U15.2 (-IN)
unnamed: R39.1, R40.2, U14.2 (-IN)
unnamed: R52.2, R54.2, R55.2, U16.3 (+IN)

Notes on the sheet:
F/T DAQ 68-PIN CONNECTOR
Note, SG6 is temp. output for optional compensation.
Analog input screw terminals (OUT=AIN+, REF=AIN-)
UEXT Header
UEXT Power selector
Homing Switches (normally open)
Limit/Kill Switches (normally closed)
Optional External 5V Power
PWM, RC Servos
Camera Trigger Outputs (0-5V)
UEXT I2C Pullups
Buffered Digital Outputs (0-5V)
Stepper/Servo Motors
Differential Amplifier + Level Shift (+/- 10V input, 0-1.2V ouput)
Normal Axes
Mirrored Axes
Dual +/- 12V Rail for OP Amps
10V Reference Voltage
Voltage Clamp (0-3.3V)
Analog Output (0-3.3V)
Direction Select (Mirrored Axes)
BAS70-04-E3-08
Mount Holes

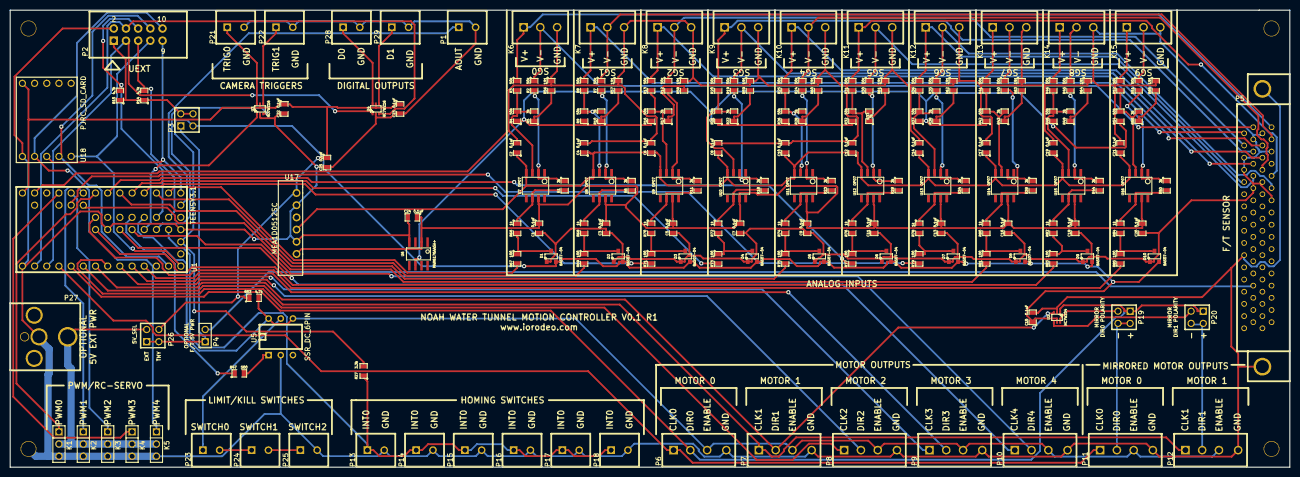
[picture p55: board motion_controller.kicad_pcb from above]

Board: 2 copper layers, 266.7 x 95.3 mm, 186 parts (0 on the bottom side), 131 nets.
