iorodeo/noah_motion_system/firmware/noah_controller/homing_controller.cpp

#include "homing_controller.h"
#include <util/atomic.h>

// Homing Pin Interrupt Callback
// --------------------------------------------------------------------------------------

void homing_callback()
{
    HomingController::disable();
    HomingController::set_home_found(true);
}


// HomingController static member data
// --------------------------------------------------------------------------------------
bool HomingController::home_found_ = true;;
uint8_t HomingController::pin_ = 0;


// HomingController Public Static Methods
// --------------------------------------------------------------------------------------
void HomingController::initialize(uint8_t pin)
{
    pin_ = pin;
    pinMode(pin_,INPUT);
    digitalWrite(pin_,HIGH);
}


bool HomingController::home_found()
{
    bool home_found_local;
    ATOMIC_BLOCK(ATOMIC_RESTORESTATE)
    {
        home_found_local = home_found_;
    }
    return home_found_local;
}


void HomingController::set_home_found(bool value)
{
    ATOMIC_BLOCK(ATOMIC_RESTORESTATE)
    {
        home_found_ = value;
    }
}


void HomingController::enable()
{
    set_home_found(false);
    attachInterrupt(pin_,homing_callback,FALLING);
}


void HomingController::disable()
{
    detachInterrupt(pin_);
}


bool HomingController::pin_state()
{
    return bool(digitalRead(pin_));
}

// HomingController Public Methods
// --------------------------------------------------------------------------------------

HomingController::HomingController(int8_t direction, uint32_t speed)
{
    set_speed(speed);
    set_direction(direction);
    velocity_controller_.disable_bounds_check();
} 


int32_t HomingController::update(int32_t position)
{
    if (home_found_)
    {
        velocity_controller_.set_velocity_setp(0);
    }
    velocity_controller_.update(position);
    return velocity();
}


void HomingController::reset()
{
    if (direction_ > 0)
    {
        velocity_controller_.set_velocity_setp( int32_t(speed_));
    }
    else
    {
        velocity_controller_.set_velocity_setp(-int32_t(speed_));
    }
    velocity_controller_.reset();
}


int32_t HomingController::velocity()
{
    return velocity_controller_.velocity();
}

uint32_t HomingController::speed()
{
    return speed_;
}


void HomingController::set_speed(uint32_t speed)
{
    speed_ = speed;
}


int8_t HomingController::direction()
{
    return direction_;
}


void HomingController::set_direction(int8_t direction)
{
    direction_ = direction;
}


uint32_t HomingController::max_speed()
{
    return velocity_controller_.max_speed();
}


void HomingController::set_max_speed(uint32_t max_speed)
{
    velocity_controller_.set_max_speed(max_speed);
}


uint32_t HomingController::accel()
{
    return velocity_controller_.max_accel();
}


void HomingController::set_accel(uint32_t accel)
{
    velocity_controller_.set_max_accel(accel);
}


void HomingController::set_velocity_setp(int32_t velocity)
{
    velocity_controller_.set_velocity_setp(velocity);
}


int32_t HomingController::velocity_setp()
{
    return velocity_controller_.velocity_setp();
}
