iorodeo/noah_motion_system/firmware/tests/system_tests/motor_test/pc/motion_controller.cpp

#include "motion_controller.hpp"
#include <iostream>
#include <fstream>
#include <cstring>
#include <csignal>
#include <iomanip>
#include <limits>
#include "msg_types.h"
#include "constants.h"
#include "joystick.hpp"

extern bool quit_flag;
const int32_t Int16Max = std::numeric_limits<int16_t>::max();

const std::string  MotionController::Default_Output_Filename("data.txt");


// MotionController public methods
// ----------------------------------------------------------------------------
MotionController::MotionController(int vid, int pid, int joystick_num)
{
    hid_dev_ = RawHIDDevice(constants::Vid,constants::Pid);
    output_filename_ = Default_Output_Filename;
    joystick_num_ = joystick_num;
}


bool MotionController::open()
{
    bool rval =  hid_dev_.open();
    if (!rval)
    {
        std::cerr << "error: unable to open device" << std::endl;
    }
    return rval;
}


bool MotionController::close()
{
    hid_dev_.close();
    return true;
}


bool MotionController::run()
{
    Joystick joystick(joystick_num_); 
    double force = 0.0;

    // Check for joystick if using captive trajectory
    if (!axis_to_model_map_.empty())
    {
        if (!joystick.isFound())
        {
            std::cerr << "error: can't find joystick" << std::endl;
            return false;
        }
    }

    // Set to trejctory start position and zero velocity
    if (!set_pos_to_start()) 
    { 
        return false; 
    }
    if (!set_vel_to_zero())  
    { 
        return false; 
    }

    // Set to velocity mode
    if (!enable_vel_ctlr_mode())  
    { 
        return false; 
    }


    // Loop over trajectory until done
    std::ofstream outfile;
    uint64_t cnt = 0;
    double t_last = 0.0;

    outfile.open(output_filename_);



    while (true)
    {
        // Receive position message
        PosMsg pos_msg;
        if (!hid_dev_.recvData(&pos_msg))
        {
            std::cerr << "error: recvData failure" << std::endl;
            if (quit_flag)
            {
                break;
            }
            continue;
        }
        if (pos_msg.msg_id != constants::PosMsgId)
        {
            std::cerr << "error: recvData expected PosMsgId" << std::endl;
            if (quit_flag)
            { 
                break;
            }
            continue;
        }
        if (pos_msg.quit_flag)
        {
            break;
        }

        // Get force measurement
        if (!axis_to_model_map_.empty())
        {
            JoystickEvent event;
            if (joystick.sample(&event))
            {
                if (event.isAxis() && (event.number==1))
                {
                    double value = double(event.value)/double(Int16Max);
                    force = constants::JoyToForce*value;
                }
            }
        }


        // Compute new motor velocities and send controller
        double t = 1.0e-6*float(pos_msg.time);
        uint32_t index = uint32_t(cnt%trajectory_.size());

        VelMsg vel_msg;
        vel_msg.msg_id = constants::VelMsgId;
        vel_msg.quit_flag = quit_flag;

        outfile << t << " ";

        for (int i=0; i<constants::NumMotor; i++)
        {
            float setpt_pos = 0.0;
            float setpt_vel = 0.0;

            if (axis_to_model_map_.count(i) > 0)
            {
                axis_to_model_map_[i].update(force,constants::Dt);
                setpt_pos = axis_to_model_map_[i].position();
                setpt_vel = axis_to_model_map_[i].velocity();
            }
            else
            {
                setpt_pos = trajectory_[index].pos[i];
                setpt_vel = trajectory_[index].vel[i];
            }
            int32_t pos_error = int32_t(setpt_pos) - pos_msg.position[i]; 
            vel_msg.velocity[i] = (constants::PGain/constants::Dt)*float(pos_error); 
            vel_msg.velocity[i] +=  constants::FGain*setpt_vel; 

            if (vel_msg.velocity[i] > 8000)
            {
                vel_msg.velocity[i] = 8000;
            }
            if (vel_msg.velocity[i] < -8000)
            {
                vel_msg.velocity[i] = -8000;
            }

            //outfile << int32_t(setpt_vel) << " " << vel_msg.velocity[i] << " ";
            outfile << int32_t(setpt_pos) << " " << pos_msg.position[i] << " ";

        }
        outfile << std::endl;

        std::cout << std::fixed << std::showpoint << std::setprecision(5);
        std::cout << t << " " << t-t_last << " " << vel_msg.velocity[0]; 
        //std::cout << t << " " << t-t_last << " " << pos_msg.position[0] << " " << vel_msg.velocity[0];
        //std::cout << t << " " << t-t_last << " " << pos_msg.position[0] << " " << vel_msg.velocity[0];
        if (!axis_to_model_map_.empty())
        {
            std::cout << " " << force;
        }
        std::cout << std::endl;

        if (!hid_dev_.sendData(&vel_msg))
        {
            std::cerr << "error: sendData" << std::endl;
        }
        cnt++;
        t_last = t;
    }

    // Set to trejctory start position and zero velocity
    set_vel_to_zero();  
    set_pos_to_start(); 

    outfile.close();
    return true;
}


void MotionController::set_output_filename(std::string filename)
{
    output_filename_ = filename;
}


std::string MotionController::get_output_filename()
{
    return output_filename_;
}


void MotionController::set_trajectory(std::vector<TrajData> trajectory)
{
    trajectory_ = trajectory;
}


std::vector<TrajData> MotionController::get_trajectory()
{
    return trajectory_;
}        


void MotionController::enable_captive_trajectory(int axis, DynamicModel model)
{
    if ((axis >=0) && (axis < constants::NumMotor))
    {
        axis_to_model_map_[axis] = model;
    }
}


void MotionController::disable_captive_trajectory(int axis)
{
    axis_to_model_map_.erase(axis);
}



// MotionController protected methods
// ----------------------------------------------------------------------------
bool MotionController::set_pos_to_start()
{
    CmdMsg cmd_msg;
    cmd_msg.msg_id = constants::CmdMsgId;
    cmd_msg.cmd_id = constants::CmdSetMotorPos;
    int32_t pos[constants::NumMotor];
    for (int i=0; i<constants::NumMotor; i++)
    {
        if (axis_to_model_map_.count(i) > 0)
        {
            pos[i] = int32_t(axis_to_model_map_[i].position());
        }
        else
        {
            pos[i] = int32_t(trajectory_[0].pos[i]);
        }
    }
    std::memcpy(cmd_msg.data,pos,sizeof(pos));

    bool rval = true;
    if (!hid_dev_.sendData(&cmd_msg))
    {
        std::cerr << "error: unable to set initial motor position" << std::endl;
        rval = false;
    }
    return rval;
}


bool MotionController::set_vel_to_zero()
{
    CmdMsg cmd_msg;
    cmd_msg.msg_id = constants::CmdMsgId;
    cmd_msg.cmd_id = constants::CmdSetMotorVel;
    float vel[constants::NumMotor];
    for (int i=0; i<constants::NumMotor; i++)
    {
        vel[i] = trajectory_[0].vel[i];
    }
    std::memcpy(cmd_msg.data,vel,sizeof(vel));

    bool rval = true;
    if (!hid_dev_.sendData(&cmd_msg))
    {
        std::cerr << "error: unable to set initial motor velocity" << std::endl;
        rval = false;
    }
    return rval;
}


bool MotionController::enable_vel_ctlr_mode()
{
    CmdMsg cmd_msg;
    cmd_msg.msg_id = constants::CmdMsgId;
    cmd_msg.cmd_id = constants::CmdStartVelCtrl;

    bool rval = true;
    if (!hid_dev_.sendData(&cmd_msg))
    {
        std::cerr << "error: unable to enter velocity control mode" << std::endl;
        rval = false;
    }
    return rval;
}


//double MotionController::get_joystick_force()
//{
//    static double force = 0.0;
//    std::cout << "get_force" << std::endl;
//    if (!axis_to_model_map_.empty())
//    {
//        JoystickEvent event;
//        if (joystick_.sample(&event))
//        {
//            if (event.isAxis() && (event.number==1))
//            {
//                double value = double(event.value)/double(Int16Max);
//                force = constants::JoyToForce*value;
//            }
//        }
//    }
//    return force;
//}
