iorodeo/noah_motion_system/firmware/tests/design_tests/rawhid_test/motor_control/pc/motion_controller.hpp

#ifndef MOTION_CONTROLLER_HPP
#define MOTION_CONTROLLER_HPP
#include <map>
#include <vector>
#include <string>
#include "trajectory.hpp"
#include "dynamic_model.hpp"
#include "rawhid_device.hpp"

class MotionController
{
    public:
        static const std::string  Default_Output_Filename;

        MotionController(int vid=0, int pid=0, int joystick_num=0);

        bool open();
        bool close();
        bool run();

        void set_output_filename(std::string filename);
        std::string get_output_filename();

        void set_trajectory(std::vector<TrajData> trajectory);
        std::vector<TrajData> get_trajectory();

        void enable_captive_trajectory(int axis, DynamicModel model);
        void disable_captive_trajectory(int axis);

    protected:

        RawHIDDevice hid_dev_;
        std::string output_filename_;
        std::vector<TrajData> trajectory_;
        std::map<int,DynamicModel> axis_to_model_map_;
        int joystick_num_;

        bool set_pos_to_start();
        bool set_vel_to_zero();
        bool enable_vel_ctlr_mode();
};

#endif
