iorodeo/noah_motion_system/firmware/tests/system_tests/motor_test/pc/constants.cpp

#include "constants.h"

namespace constants
{
    const int Vid = 0x16C0;
    const int Pid = 0x0486;
    const int RawHidTimeout = 100;

    const double PGain = 0.5;
    const double FGain = 1.0;
    const double Dt = 0.005;
    const double JoyToForce = 6500.0;

} 
