iorodeo/noah_motion_system/firmware/tests/design_tests/rawhid_test/motor_control/pc/msg_types.h

#ifndef TYPES_H
#define TYPES_H

#include "constants.h"

struct __attribute__((packed)) CmdMsg 
{
    uint16_t  msg_id;
    uint16_t  cmd_id; 
    uint8_t   data[60];
};

struct __attribute__((packed)) RspMsg
{
    uint16_t  msg_id;
    uint16_t  cmd_id;
    bool      success;
    char      message[59];
};

struct __attribute__((packed)) PosMsg
{
    uint16_t  msg_id;
    uint64_t  time;
    int32_t   position[constants::NumMotor];
    bool      quit_flag;
    uint8_t   padding[53-constants::NumMotor*4];
};


struct __attribute__((packed)) VelMsg
{
    uint16_t  msg_id;
    float     velocity[constants::NumMotor];
    bool      quit_flag;
    uint8_t   padding[61-constants::NumMotor*4];
};


#endif
