iorodeo/noah_motion_system/firmware/tests/design_tests/usb_serial_test/usb_timer_test_ui.py

# -*- coding: utf-8 -*-

# Form implementation generated from reading ui file 'usb_timer_test.ui'
#
# Created: Mon Nov 16 12:26:06 2015
#      by: PyQt4 UI code generator 4.10.4
#
# WARNING! All changes made in this file will be lost!

from PyQt4 import QtCore, QtGui

try:
    _fromUtf8 = QtCore.QString.fromUtf8
except AttributeError:
    def _fromUtf8(s):
        return s

try:
    _encoding = QtGui.QApplication.UnicodeUTF8
    def _translate(context, text, disambig):
        return QtGui.QApplication.translate(context, text, disambig, _encoding)
except AttributeError:
    def _translate(context, text, disambig):
        return QtGui.QApplication.translate(context, text, disambig)

class Ui_MainWindow(object):
    def setupUi(self, MainWindow):
        MainWindow.setObjectName(_fromUtf8("MainWindow"))
        MainWindow.resize(346, 86)
        self.centralwidget = QtGui.QWidget(MainWindow)
        self.centralwidget.setObjectName(_fromUtf8("centralwidget"))
        self.verticalLayout = QtGui.QVBoxLayout(self.centralwidget)
        self.verticalLayout.setObjectName(_fromUtf8("verticalLayout"))
        spacerItem = QtGui.QSpacerItem(20, 40, QtGui.QSizePolicy.Minimum, QtGui.QSizePolicy.Expanding)
        self.verticalLayout.addItem(spacerItem)
        self.widget = QtGui.QWidget(self.centralwidget)
        self.widget.setObjectName(_fromUtf8("widget"))
        self.horizontalLayout = QtGui.QHBoxLayout(self.widget)
        self.horizontalLayout.setMargin(0)
        self.horizontalLayout.setObjectName(_fromUtf8("horizontalLayout"))
        spacerItem1 = QtGui.QSpacerItem(40, 20, QtGui.QSizePolicy.Expanding, QtGui.QSizePolicy.Minimum)
        self.horizontalLayout.addItem(spacerItem1)
        self.startStopPushButton = QtGui.QPushButton(self.widget)
        self.startStopPushButton.setObjectName(_fromUtf8("startStopPushButton"))
        self.horizontalLayout.addWidget(self.startStopPushButton)
        spacerItem2 = QtGui.QSpacerItem(125, 20, QtGui.QSizePolicy.Expanding, QtGui.QSizePolicy.Minimum)
        self.horizontalLayout.addItem(spacerItem2)
        self.verticalLayout.addWidget(self.widget)
        spacerItem3 = QtGui.QSpacerItem(20, 40, QtGui.QSizePolicy.Minimum, QtGui.QSizePolicy.Expanding)
        self.verticalLayout.addItem(spacerItem3)
        MainWindow.setCentralWidget(self.centralwidget)
        self.menubar = QtGui.QMenuBar(MainWindow)
        self.menubar.setGeometry(QtCore.QRect(0, 0, 346, 20))
        self.menubar.setObjectName(_fromUtf8("menubar"))
        MainWindow.setMenuBar(self.menubar)
        self.statusbar = QtGui.QStatusBar(MainWindow)
        self.statusbar.setObjectName(_fromUtf8("statusbar"))
        MainWindow.setStatusBar(self.statusbar)

        self.retranslateUi(MainWindow)
        QtCore.QMetaObject.connectSlotsByName(MainWindow)

    def retranslateUi(self, MainWindow):
        MainWindow.setWindowTitle(_translate("MainWindow", "USB Timer Test", None))
        self.startStopPushButton.setText(_translate("MainWindow", "Start", None))
