iorodeo/noah_motion_system/(commit log)

2015-11-16 Project creation.
    [BOM.xlsx, mounting_frame.dxf]
2015-11-30 Added design for gantry carriage plate.
    [gantry_carriage_plate.dxf]
2015-12-01 Added separate drawings of carriage and gantry plates.
    [carriage_plate.dxf, gantry_plate.dxf, plate_assembly.dxf]
2015-12-01 Added annotations.
    [gantry_plate.dxf, plate_assembly.dxf]
2015-12-01 Changed directory name.
    [carriage_plate.dxf, gantry_plate.dxf, plate_assembly.dxf]
2016-02-19 Added spring mass to joystick demo.
2016-03-01 Worked on motor controller demo.
2016-03-02 Added display to teensy code.
2016-03-02 Added new Stepper class - hopefully faster.
2016-03-02 Fixed bug in Stepper class step update.
    [constants.cpp, motion_controller.cpp, trajectory.cpp]
2016-03-24 Finished initial motion controller schematic.
    [BOM.xlsx, carriage_plate.dxf, gantry_plate.dxf, motion_controller.sch, mounting_frame.dxf, plate_assembly.dxf]
2016-04-02 Fixed motion controller schem. so that design rules check is satisfied. Addd 2nd resistor to differential amplifier - to make it easy to find components with correct values.
    [motion_controller.kicad_pcb, motion_controller.sch]
2016-04-05 Changed clamping circuit. Worked on footprint assignment.
    [motion_controller.sch]
2016-04-05 Finished footprint association.
    [motion_controller.sch]
2016-04-05 Worked on layout.
    [motion_controller.sch]
2016-04-07 Worked on motion controller PCB layout.
    [motion_controller.kicad_pcb, motion_controller.sch]
2016-04-08 Worked on layout of analog input subsystem.
    [motion_controller.kicad_pcb, motion_controller.sch]
2016-04-08 Added PJRC SD card. Changed so that double schottky diodes in a analog clamp use AGND instead of GND. Worked on layout.
    [motion_controller.kicad_pcb, motion_controller.sch]
2016-04-09 Finished initial layout of motion controller pcb.
    [motion_controller.dsn, motion_controller.kicad_pcb, motion_controller.sch]
2016-04-09 Finished preliminary routing of motion controller PCB.
    [motion_controller.dsn, motion_controller.kicad_pcb, motion_controller.sch]
2016-04-10 Worked on motion controller PCB annotation, routing and layout.
    [motion_controller.dsn, motion_controller.kicad_pcb]
2016-04-11 Finished motion controller pcb annotation and re-routed board.
    [motion_controller.dsn, motion_controller.kicad_pcb, motion_controller.sch]
2016-04-11 Added gerber files for V0.1 R1 of motion controller pcb.
    [motion_controller-B_Cu.gbl, motion_controller-B_Mask.gbs, motion_controller-B_SilkS.gbo, motion_controller-Edge_Cuts.gbr, motion_controller-F_Cu.gtl, motion_controller-F_Mask.gts, motion_controller-F_SilkS.gto, motion_controller.drl]
2016-04-11 Modified motion controller pcb slightly - made so that only one mounting hole is grounded.
    [motion_controller-B_Cu.gbl, motion_controller-B_Mask.gbs, motion_controller-B_SilkS.gbo, motion_controller-Edge_Cuts.gbr, motion_controller-F_Cu.gtl, motion_controller-F_Mask.gts, motion_controller-F_SilkS.gto, motion_controller.drl]
2016-04-11 Added .zip archive for motion_controller pcb V0.1 R1 gerber files.
2016-04-14 Worked on BOM for motion controller PCB.
    [motion_controller.kicad_pcb, motion_controller.sch]
2016-04-14 Added sympy derivation of differential amplifier gain for motion controller pcb.
    [BOM.xls, motion_controller.kicad_pcb, motion_controller.sch]
2016-04-15 Re-worked differential amplifier op amp bias network symbolic algebra calculation to use solveset instead of solve.
    [BOM.xls, motion_controller.sch]
2016-04-15 Worked on BOM.
    [BOM.xls]
2016-04-16 Finished motion controller PCB BOM.
    [BOM.xls]
2016-04-18 Added circuit simulation for differential amplifier.
    [diff_amp.sch]
2016-05-05 Fixed part issue in BOM - specified 8-SO rather than 8-SOIC.
    [BOM.xls]
2016-05-31 Added some simple firmware tests for new motion controller pcb.
2016-06-23 Modified gantry mount plate design.
    [carriage_plate.dxf, gantry_plate.dxf, lower_gantry_plate.dxf, plate_assembly.dxf, upper_gantry_plate.dxf]
2016-06-24 Added rotary axis mount plate. Added waterjet cutting layout for parts.
    [assembly.dxf, carriage_plate.dxf, lower_gantry_plate.dxf, rotary_axis_mount_plate.dxf, waterjet_layout.dxf]
2016-07-02 Renamed directory.
    [BOM.xlsx, assembly.dxf, carriage_plate.dxf, gantry_plate.dxf, lower_gantry_plate.dxf, plate_assembly.dxf, rotary_axis_mount_plate.dxf, upper_gantry_plate.dxf]
2016-07-02 Added design for limit switch mount plates.
    [assembly.dxf, bottom_plate.dxf, carriage_mods_plus_rotary_mount.dxf, carriage_plate.dxf, gantry_plate.dxf, lower_gantry_plate.dxf, plate_assembly.dxf, top_plate.dxf]
2016-07-02 Added lasercutting layout for limit switch mounts.
    [bottom_plate.dxf, carriage_mods_plus_rotary_mount.dxf, limit_switch_mounts.dxf]
2016-07-02 Added gcode and gcode generation for cutting limit switch mounts.
2016-07-03 Added second limit switch mount design + laser cutting layout.
    [bottom_plate.dxf, carriage_switch_mount.dxf, limit_switch_mounts_layout1.dxf, limit_switch_mounts_layout2.dxf, top_plate.dxf, vertical_axis_mount.dxf]
2016-07-03 Renamed limit switch gcode file.
2016-07-03 Fixed issue with limit switch mount type2 design. Added gcode for laser cutting..
    [carriage_switch_mount.dxf, limit_switch_mounts_layout2.dxf]
2016-07-16 Added tooling plate to force sensor adaptor plate design.
    [force_sensor.dxf, force_sensor_to_tooling_plate.dxf, sherline_toolling_plate.dxf]
2016-07-18 Fixed issue with rotary axis mount plate. Worked on force sensor mount.
    [force_sensor_to_model_1.dxf, force_sensor_to_model_2.dxf, rotary_axis_mount_plate.dxf]
2016-07-18 Fixed rotary axis mount in waterjet layout.
    [carriage_mods_plus_rotary_mount.dxf]
2016-07-18 Finished initial design of force sensor to model adapter plates.
    [force_sensor_to_model_2_0p25-20.dxf, force_sensor_to_model_2_10-32.dxf, force_sensor_to_tooling_plate.dxf]
2016-07-18 Added waterjet layout for force sensor mounts and 2nd copy of rotary axis mount.
    [force_sensor_plus_rotary_mount.dxf]
2016-07-22 Rearranged mechanics directories.
    [BOM.xlsx, assembly.dxf, bottom_plate.dxf, carriage_mods_plus_rotary_mount.dxf, carriage_plate.dxf, carriage_switch_mount.dxf, force_sensor.dxf, force_sensor_plus_rotary_mount.dxf]
2016-07-22 Added design and gcode generation for power switch plate.
    [power_switch_plate.dxf]
2016-07-22 Made minor modifications for power_switch_plate gcode gen. Made gcode for cutting.
2016-07-22 Added design for bulkhead connector plate.
    [bulkhead_connector_plate.dxf]
2016-07-23 Worked on power supply mount plate.
    [power_supply_plate.dxf]
2016-07-25 Worked on electronic mounting plates.
    [cable_tie_holder.dxf, finned_heat_sink.dxf, main_plate.dxf, motion_controller_pcb.dxf]
2016-07-27 Finished design of main electronics mount plate.
    [main_plate.dxf, power_supply_plate.dxf]
2016-07-28 Added gcode generation fro bulkhead_connector_plate.
    [layout.dxf]
2016-07-28 Removed pocket_drill anded proper peck drills for cuttinb bulkhead connector mount plates.
    [layout.dxf]
2016-07-30 Added designs for mdf backing plates and clear acrylic cover plates.
    [lower_cover_plate.dxf, main_plate.dxf, mdf_main_plate_backing.dxf, mdf_switch_plate_backing.dxf, upper_cover_plate.dxf]
2016-07-30 Added gcode generation for power supply mount plate.
    [power_supply_plate.dxf]
2016-07-31 Added gcode generation for switch plate mdf backing.
    [mdf_switch_plate_backing.dxf]
2016-07-31 Added gcode generation for electronics mount main plate.
    [main_plate.dxf]
2016-07-31 Added dimensions to eleectronics mount main plate cnc layout file.
    [main_plate.dxf]
2016-07-31 Added gcode for cutting main electronics mount plate.
    [main_plate.dxf]
2016-08-01 Added gcode generation and gcode for cutting mdf backing plate for main electronics board.
    [mdf_main_plate_backing.dxf]
2016-08-03 Added design for upper and lower gantry foot plates.
    [lower_block.dxf, upper_block.dxf]
2016-08-03 Added cnc layout for gantry mdf riser blocks.
    [layout.dxf, lower_block.dxf, upper_block.dxf]
2016-08-04 Added layout, gcode and gcode generation for mdf_riser_blocks.
    [#main_plate.dxf, layout.dxf]
2016-08-04 Added cnc for cutting 0.25in mdf riser blocks.
    [layout.dxf]
2016-08-15 Worked on firmware. Added stepper class and continued to flush out constants for triggering, steppers, pwm, etc. Worked on SystemState class and timer updates.
2016-08-16 Worked on controller firmware - added Trigger class for handling camera triggers.
2016-08-16 Worked on firmware. Added velocity controller. Added bounds checking to steppers - last resort hard stop.
2016-08-17 Worked on firmware. Flushed out velocity controller.
2016-08-17 Added notes to velocity controller's update function.
2016-08-18 Worked on firmware homing controller.
2016-08-19 Fixed issues with HomingController. Added EStopMonitor.
    [constants.cpp, constants.h, estop_monitor.cpp, estop_monitor.h, homing_controller.cpp, homing_controller.h, system_state.cpp, system_state.h]
2016-08-19 Worked on firmware. Modified update functions for motion mode controllers so that is returns new velocity as this makes things a little cleaner. Work on modes and communications.
2016-08-20 Flushed out rawhid comms for homing and positioning modes. Fixed issue with EStopMonitor - need delay after turn on and signal change isnt' super quick.
    [constants.cpp, constants.h, estop_monitor.cpp, estop_monitor.h, rawhid_msg_types.h, system_state.cpp, system_state.h]
2016-08-22 Worked on firmware. Flushed out communications for velocity controller and stop motion command.
2016-08-23 Worked on firmare and host software. Flushed on host side homing and positioning commands.
2016-08-25 Fixed bug in outscan method when checking the set velocity control mode has been received..
2016-09-04 Modified x axis homing direction. Modified test trajectory.
2016-09-11 Added temporary check on raw hid device nums.
2016-09-20 Work on six axis force torque convertion.
2016-09-21 Worked on six axis sensor force torque conversions.
2016-09-22 Added print_info method to FT_SensorCal class.
2016-09-23 Worked on methods for loading configuration from json file. Added example config.json and force/torque sensor calibration.
2016-09-23 Added command to display force torque sensor information.
2016-09-24 Worked on analog_input to force/torque conversion in outscan data. Added automatic setting of temperature compensation if available. Fixed bug in FT_SensorCal which made is_initialized always return 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
    [mcontrol.cpp]
2016-09-28 Worked on adding force and torque units as attribute to hdf5 dataset.
2016-09-28 Modified OutscanData so that force and torque units are added as an attribute to the force_and_torque data set in the hdf5 output file.
2016-10-02 Added addition items to configuration file. Such as outscan start delay, outscan number of bias samples, the joystick device, the joystick axis mapping, the joystick invert table. Add addition comman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
    [mcontrol.cpp, mcontrol.hpp, mcontrol_help.cpp]
2016-10-02 Worked on command for checking if ready for outscan. Not quite done - need to set exit status correctly.
    [mcontrol.cpp, mcontrol.hpp, mcontrol_help.cpp]
2016-10-02 Modified mcontrol command app so that exit codes are set correctly.
    [mcontrol.cpp, mcontrol.hpp]
2016-10-02 Worked on additonal commands for mcontrol eg. get-ai-samples, ..., set-trigger-freq, etc.
2016-10-03 Added commands for setting device configuration - min_position, max_postion, max_speed, max_accel, homing_direction.
2016-10-03 Added joystick_pendant method to Controller and mcontrol 'joystick' command. Added joystick velocity settings to json configuration.
2016-10-04 Modified json configuration. Add force torque sensor calibration from NOAH sensor.
2016-10-04 Added methods and mcontrol commands for getting/displaying forces and torques.
2016-10-04 Added layouts and gcode files for lasercutting acrylic cover plates for electronics.
    [limit_switch_mounts_layout3.dxf, lower_cover_plate.dxf, upper_cover_plate.dxf]
2016-10-04 Modifications for controller.cpp - debugging homing issue.
2016-10-05 Fixed firmware bug which caused homing failure when all axes where not already homed.
    [homing_controller.cpp, system_state.cpp]
2016-10-05 Worked on home issue - fixed a few more issues.
    [mcontrol.cpp]
2016-10-20 Modified homing so that axes are backed off of the homing switches before and after homing.
2016-10-20 Modified firmware and software so that device configuration can be stored in eeprom.
2016-10-27 Added usb command for checking homing pin state. Added controller method and program command for checking homing pin state. Modified software so that after the pre-homing backoff the home pin state i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
    [dev_constants.h, homing_controller.cpp, homing_controller.h, mcontrol.cpp, mcontrol.hpp, mcontrol_help.cpp, system_state.cpp, system_state.h]
2016-11-03 Added commanded position, commanded velocity, and dio to outscan data.
2016-11-10 Fixed bug in string stream output.
    [mcontrol_help.cpp]
2016-11-10 Add udev rules for teensy.
2016-12-08 Added new limit switch mounting bracket designs.
    [bottom_plate.dxf, carriage_switch_mount.dxf, top_plate.dxf, vertical_axis_mount.dxf]
2016-12-08 Added layout for cutting type3 and type4 limit switch mounting brackets.
    [limit_switch_mounts_layout1.dxf, limit_switch_mounts_layout2.dxf, limit_switch_mounts_layout3.dxf, type_3_and_4_layout_1.dxf]
2016-12-08 Added gcode for cutting type 3 and 4 limit switch mounting brackets.
2017-02-24 Added design for new limit switch mount.
    [bottom_plate.dxf, layout.dxf, top_plate.dxf]
2017-03-04 Added gcode for cutting type5 limit switch mount.
    [bottom_plate.dxf, layout.dxf]
2017-07-09 Added basic socket.io example which demonstrates how to send data from c++ to server via socket.io. The server then broadcasts the data to all connected clients.
2017-08-15 Increase size of object sent by socket.io test clent to 50 items as test.
